itsTasos/RAPS-5/manufacturing/gerbers/drill_report.txt

Drill report for RAPS-5_V1.kicad_pcb
Created on 2026-10-02T12:42:03

Copper Layer Stackup:
    =============================================================
    L1 :  F.Cu                      front
    L2 :  In1.Cu                    in1
    L3 :  In2.Cu                    in2
    L4 :  B.Cu                      back

Drill file 'RAPS-5_V1-PTH.drl' contains
    plated through holes:
    =============================================================
    T1  0.300mm  0.0118"  (161 holes))
    T2  0.400mm  0.0157"  (29 holes))
    T3  0.500mm  0.0197"  (14 holes))
    T4  1.100mm  0.0433"  (6 holes))

    Total plated holes count 210

Drill file 'RAPS-5_V1-NPTH.drl' contains
    unplated through holes:
    =============================================================
    T1  2.200mm  0.0866"  (4 holes))

    Total unplated holes count 4
