itsTasos/RAPS-5/validation/bench_results.csv

Test_ID | Source_mode | VIN_A_set_V | VIN_B_set_V | Load_set_A | Ambient_C | Measured_VIN_A_V | Measured_VIN_B_V | IIN_A_A | IIN_B_A | Local_A_V | Local_B_V | BUS_V | Ripple_pp_mV_20MHz | Hottest_case_C | Hot_component | Duration_min | PG_A | PG_B | PG_BUS | Pass_Fail | Notes
DC01 | A only | 6.7 |  | 0.1
DC02 | A only | 6.7 |  | 1
DC03 | A only | 6.7 |  | 2
DC04 | A only | 6.7 |  | 3
DC05 | A only | 8.4 |  | 0.1
DC06 | A only | 8.4 |  | 1
DC07 | A only | 8.4 |  | 2
DC08 | A only | 8.4 |  | 3
DC09 | A only | 16.8 |  | 0.1
DC10 | A only | 16.8 |  | 1
DC11 | A only | 16.8 |  | 2
DC12 | A only | 16.8 |  | 3
DC13 | A only | 25.2 |  | 0.1
DC14 | A only | 25.2 |  | 1
DC15 | A only | 25.2 |  | 2
DC16 | A only | 25.2 |  | 3
DC17 | B only |  | 6.7 | 0.1
DC18 | B only |  | 6.7 | 1
DC19 | B only |  | 6.7 | 2
DC20 | B only |  | 6.7 | 3
DC21 | B only |  | 8.4 | 0.1
DC22 | B only |  | 8.4 | 1
DC23 | B only |  | 8.4 | 2
DC24 | B only |  | 8.4 | 3
DC25 | B only |  | 16.8 | 0.1
DC26 | B only |  | 16.8 | 1
DC27 | B only |  | 16.8 | 2
DC28 | B only |  | 16.8 | 3
DC29 | B only |  | 25.2 | 0.1
DC30 | B only |  | 25.2 | 1
DC31 | B only |  | 25.2 | 2
DC32 | B only |  | 25.2 | 3
DC33 | Both | 6.7 | 6.7 | 0.1
DC34 | Both | 6.7 | 6.7 | 1
DC35 | Both | 6.7 | 6.7 | 2
DC36 | Both | 6.7 | 6.7 | 3
DC37 | Both | 8.4 | 8.4 | 0.1
DC38 | Both | 8.4 | 8.4 | 1
DC39 | Both | 8.4 | 8.4 | 2
DC40 | Both | 8.4 | 8.4 | 3
DC41 | Both | 16.8 | 16.8 | 0.1
DC42 | Both | 16.8 | 16.8 | 1
DC43 | Both | 16.8 | 16.8 | 2
DC44 | Both | 16.8 | 16.8 | 3
DC45 | Both | 25.2 | 25.2 | 0.1
DC46 | Both | 25.2 | 25.2 | 1
DC47 | Both | 25.2 | 25.2 | 2
DC48 | Both | 25.2 | 25.2 | 3
DC49 | Both | 6.7 | 25.2 | 0.1
DC50 | Both | 6.7 | 25.2 | 1
DC51 | Both | 6.7 | 25.2 | 2
DC52 | Both | 6.7 | 25.2 | 3
DC53 | Both | 25.2 | 6.7 | 0.1
DC54 | Both | 25.2 | 6.7 | 1
DC55 | Both | 25.2 | 6.7 | 2
DC56 | Both | 25.2 | 6.7 | 3
