itsTasos/RAPS-5/docs/drawings/RAPS-5_schematic.pdf

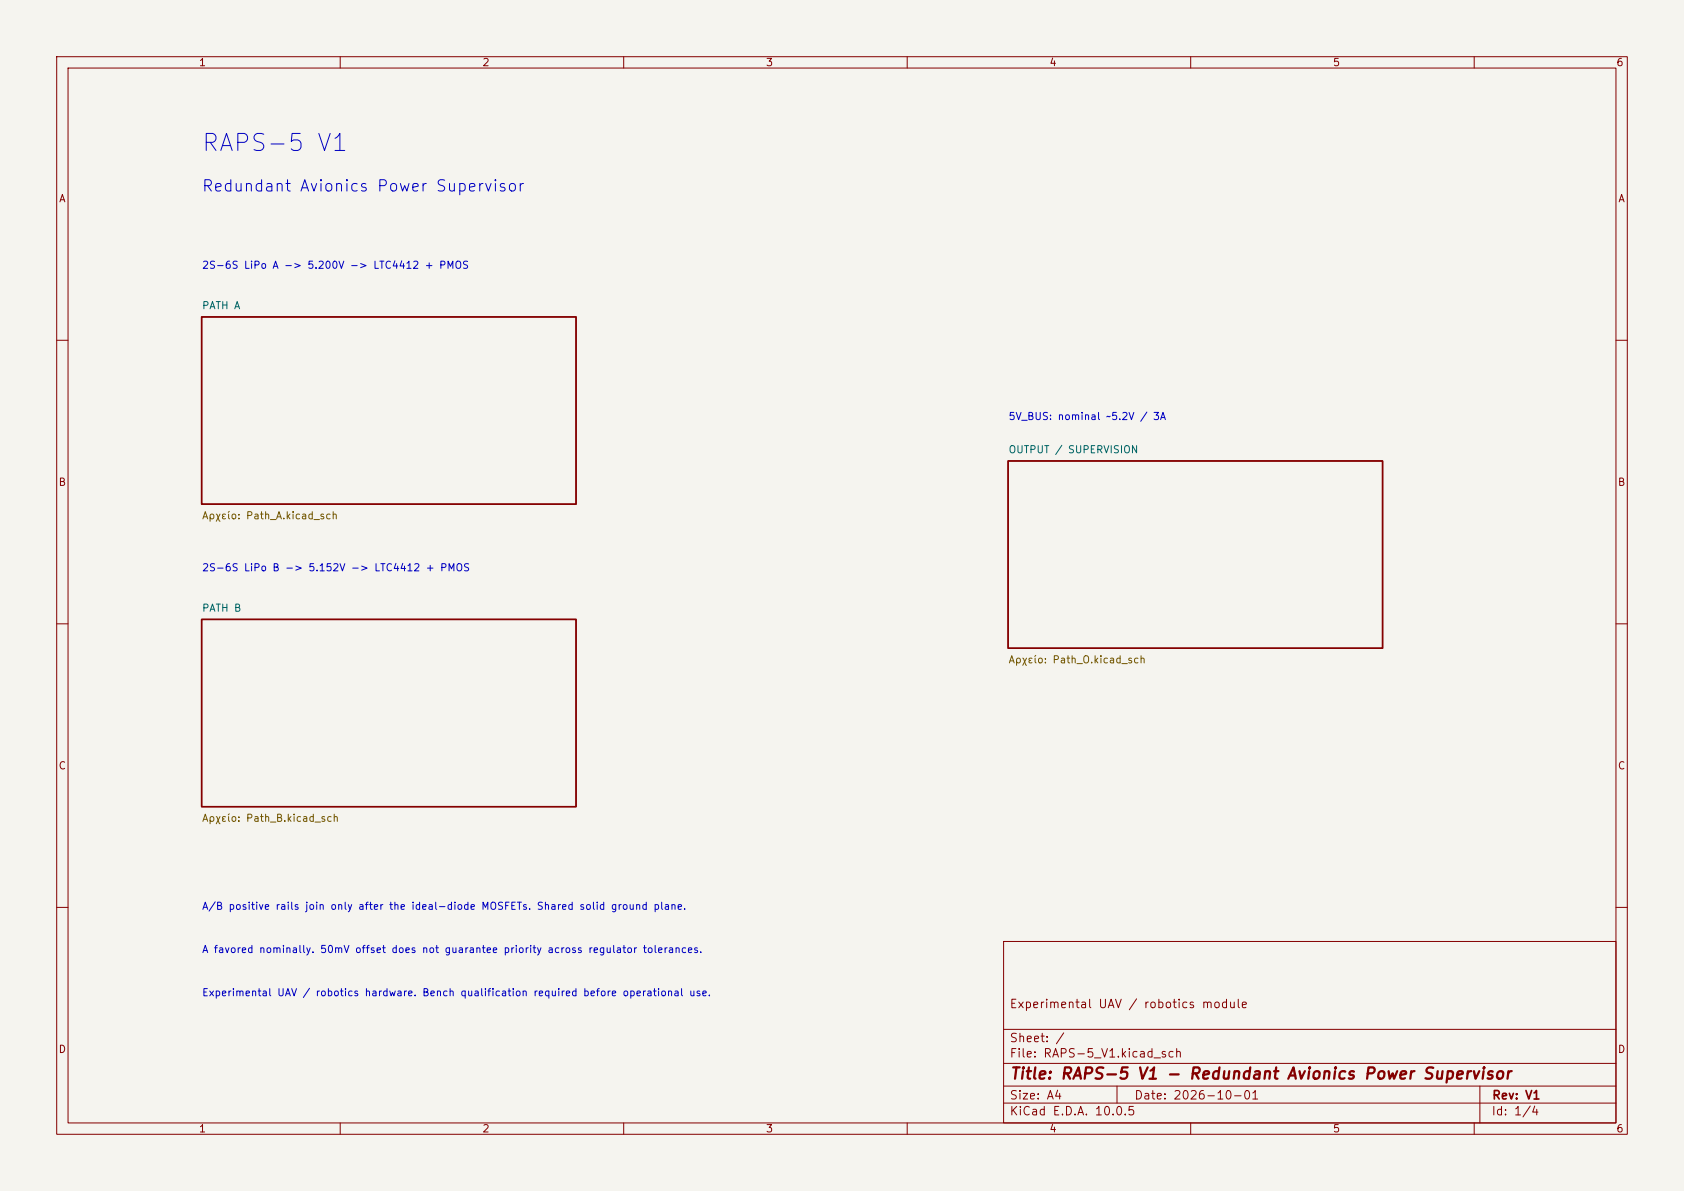
[picture p4: page 1]

A/B positive rails join only after the ideal-diode MOSFETs. Shared solid ground plane. A favored nominally. 50mV offset does not guarantee priority across regulator tolerances. RAPS-5 V1

Redundant Avionics Power Supervisor

Experimental UAV / robotics hardware. Bench qualification required before operational use. 2S-6S LiPo B -> 5.152V -> LTC4412 + PMOS

Experimental UAV / robotics module

Sheet: /
File: RAPS-5_V1.kicad_sch
Title: RAPS-5 V1 - Redundant Avionics Power Supervisor

Size: A4 | Rev: V1
KiCad E.D.A. 10.0.5 | Id: 1/4

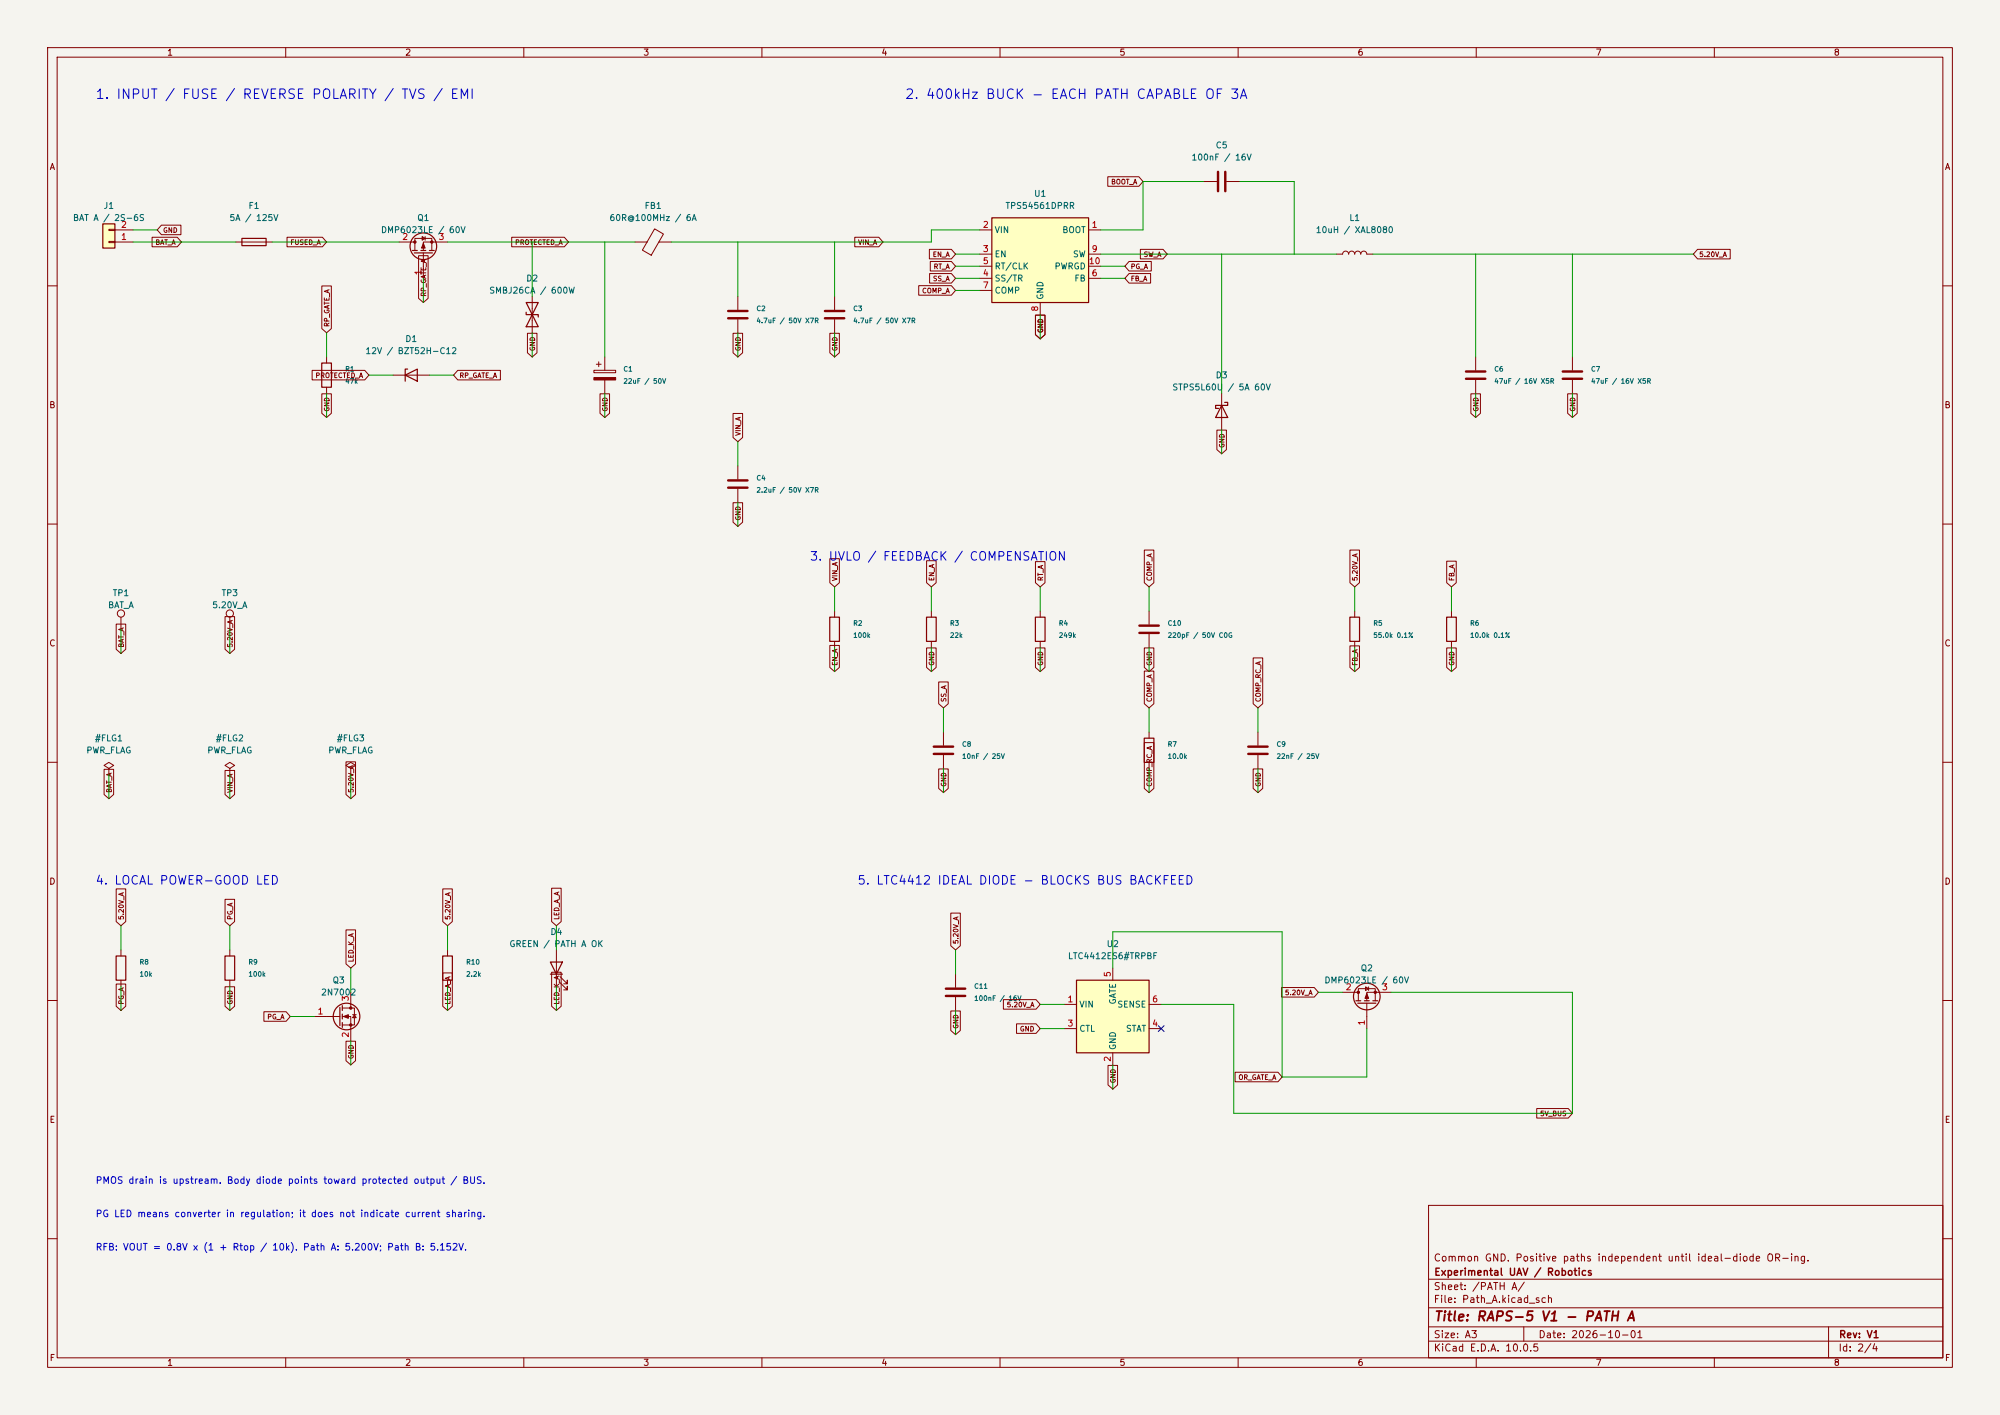
[picture p5: page 2]

1. INPUT / FUSE / REVERSE POLARITY / TVS / EMI

2. 400kHz BUCK - EACH PATH CAPABLE OF 3A

5. LTC4412 IDEAL DIODE - BLOCKS BUS BACKFEED

PMOS drain is upstream. Body diode points toward protected output / BUS.

PG LED means converter in regulation; it does not indicate current sharing.

RFB: VOUT = 0.8V x (1 + Rtop / 10k). Path A: 5.200V; Path B: 5.152V.

Common GND. Positive paths independent until ideal-diode OR-ing.
Experimental UAV / Robotics
Sheet: /PATH A/
File: Path_A.kicad_sch
Title: RAPS-5 V1 - PATH A

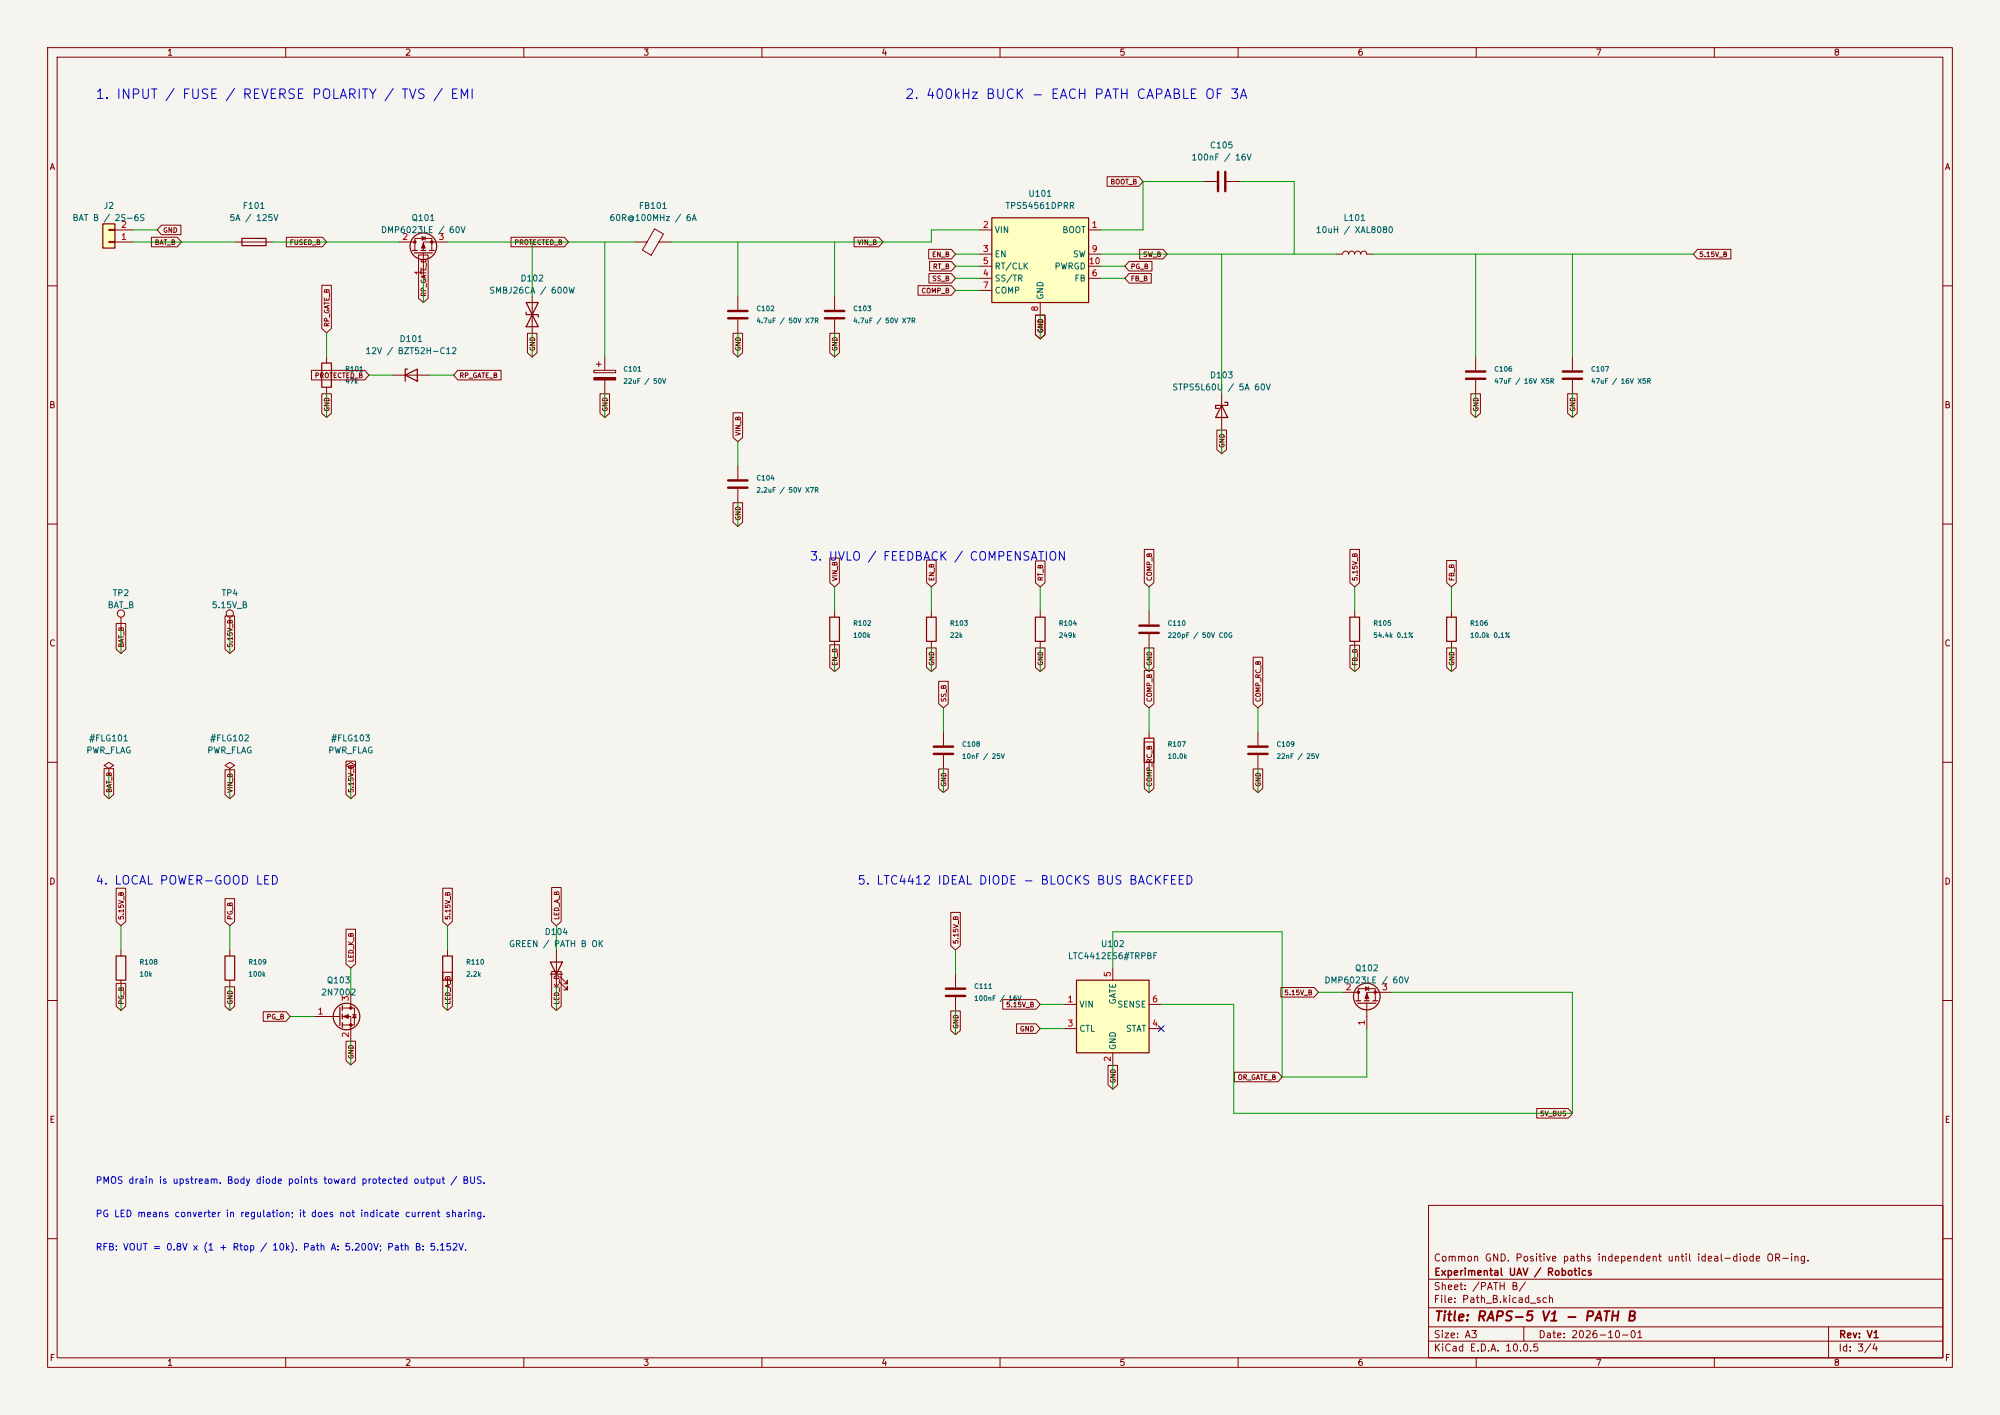
[picture p6: page 3]

1. INPUT / FUSE / REVERSE POLARITY / TVS / EMI

2. 400kHz BUCK - EACH PATH CAPABLE OF 3A

4. LOCAL POWER-GOOD LED

PMOS drain is upstream. Body diode points toward protected output / BUS.

PG LED means converter in regulation; it does not indicate current sharing.

Common GND. Positive paths independent until ideal-diode OR-ing.
Experimental UAV / Robotics
Sheet: /PATH B/
File: Path_B.kicad_sch
Title: RAPS-5 V1 - PATH B

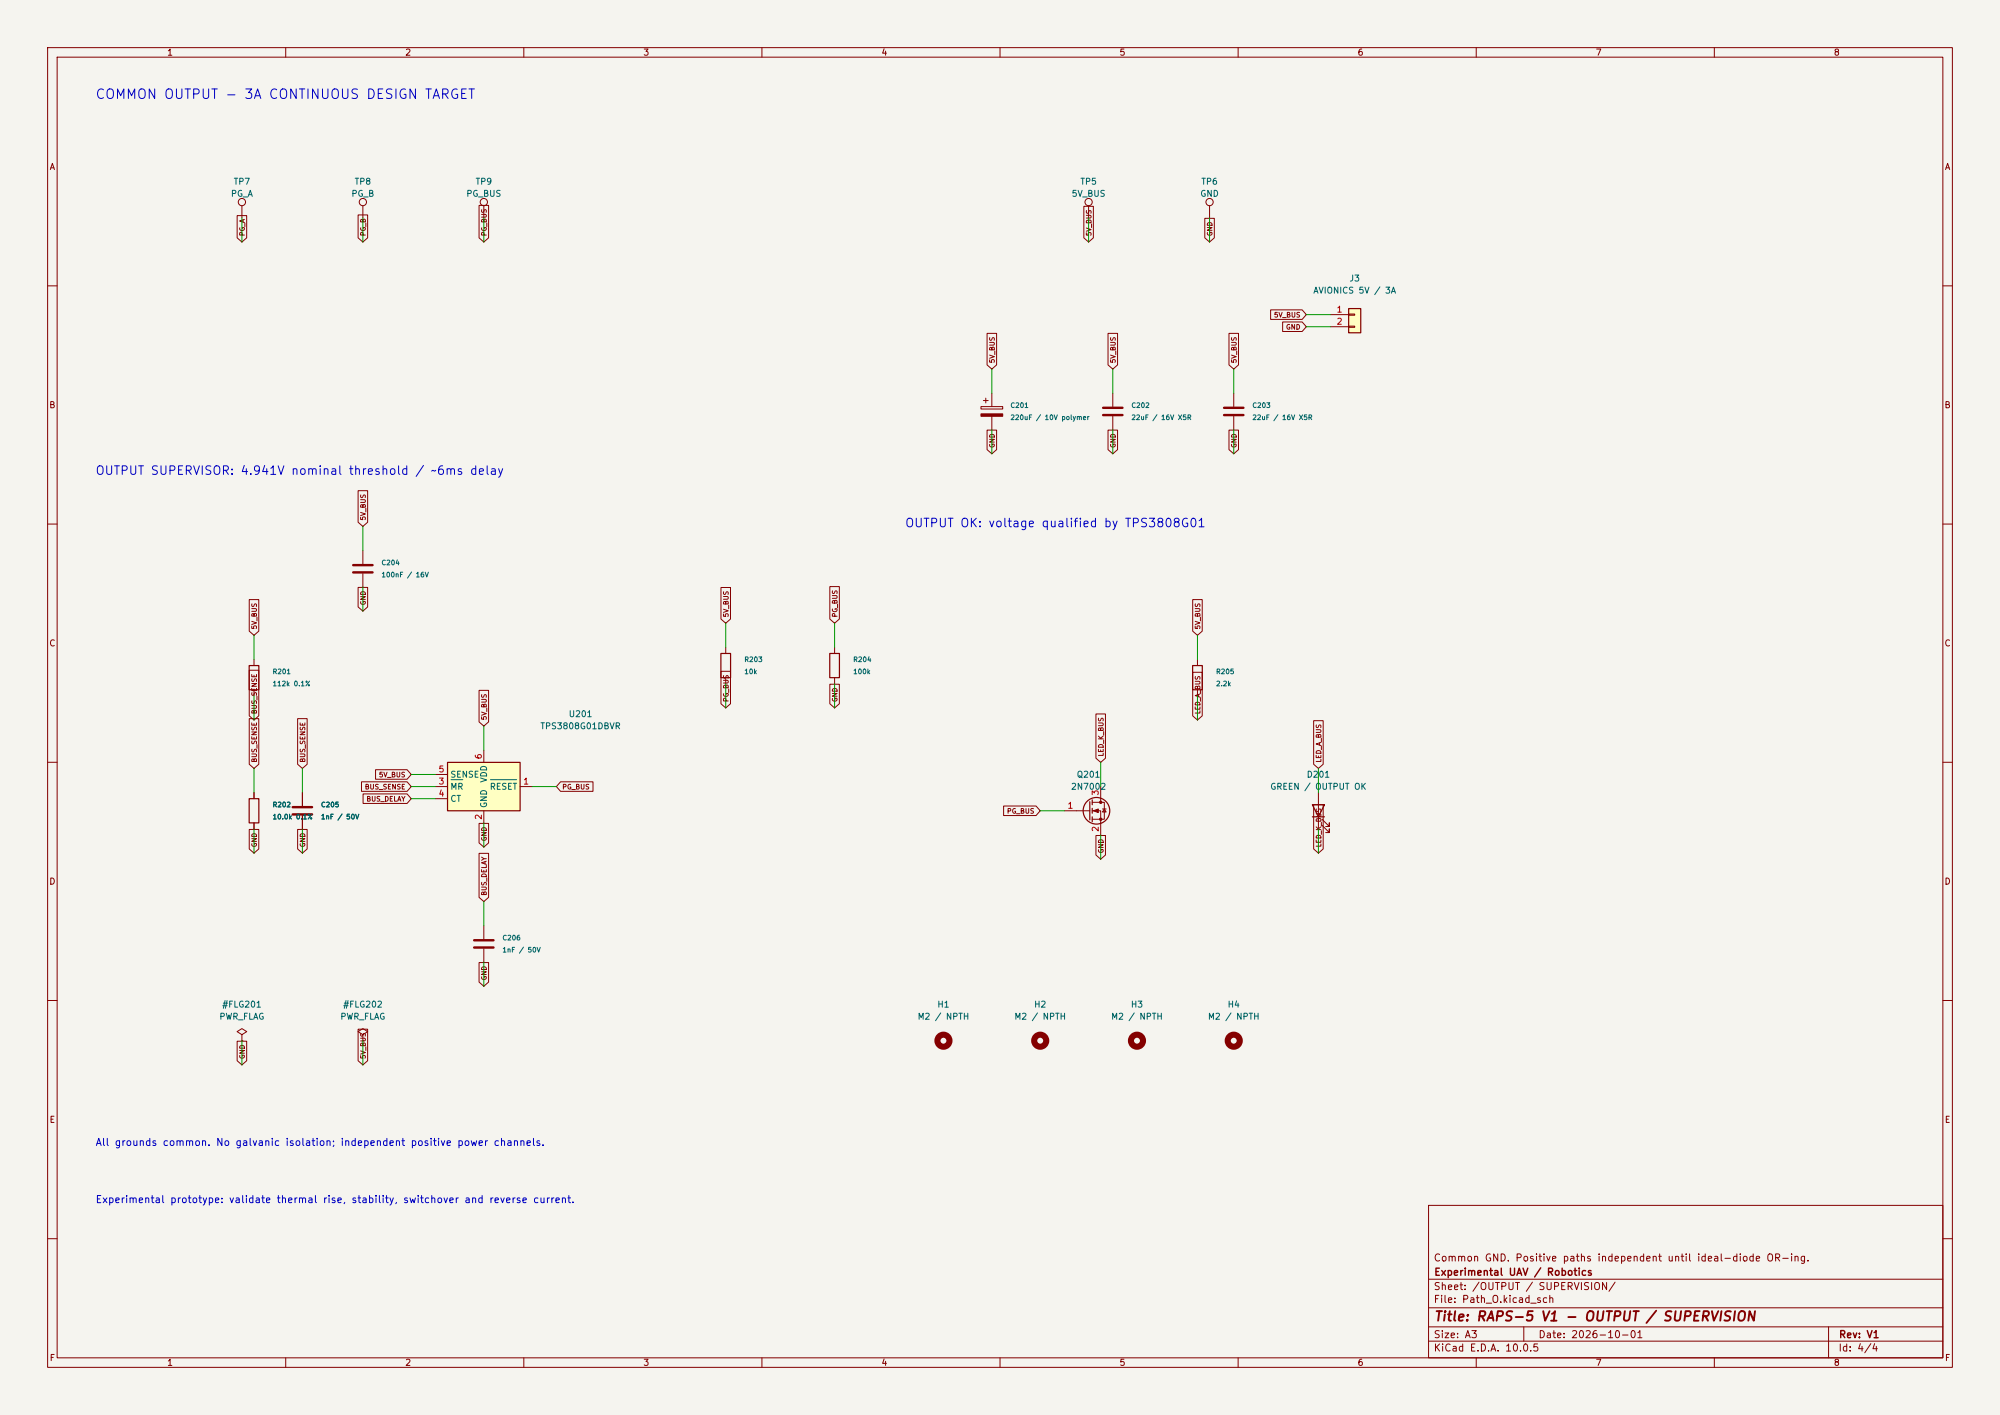
[picture p7: page 4]

COMMON OUTPUT - 3A CONTINUOUS DESIGN TARGET
BUS_SENSE 5V_BUS PG_B

OUTPUT SUPERVISOR: 4.941V nominal threshold / ~6ms delay

OUTPUT OK: voltage qualified by TPS3808G01

All grounds common. No galvanic isolation; independent positive power channels.

Experimental prototype: validate thermal rise, stability, switchover and reverse current.

Common GND. Positive paths independent until ideal-diode OR-ing.
Experimental UAV / Robotics
Sheet: /OUTPUT / SUPERVISION/
File: Path_O.kicad_sch
Title: RAPS-5 V1 - OUTPUT / SUPERVISION
