itsTasos/RAPS-5/docs/drawings/RAPS-5_assembly.pdf

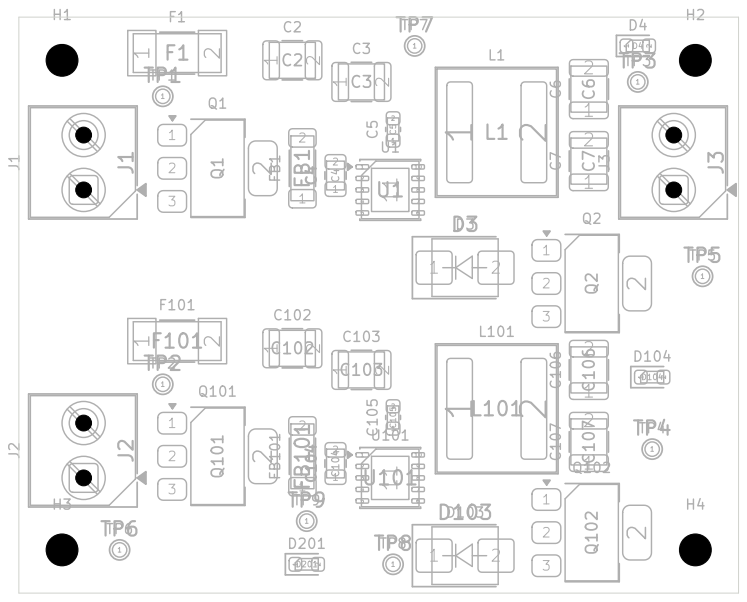
[picture p8: page 1]

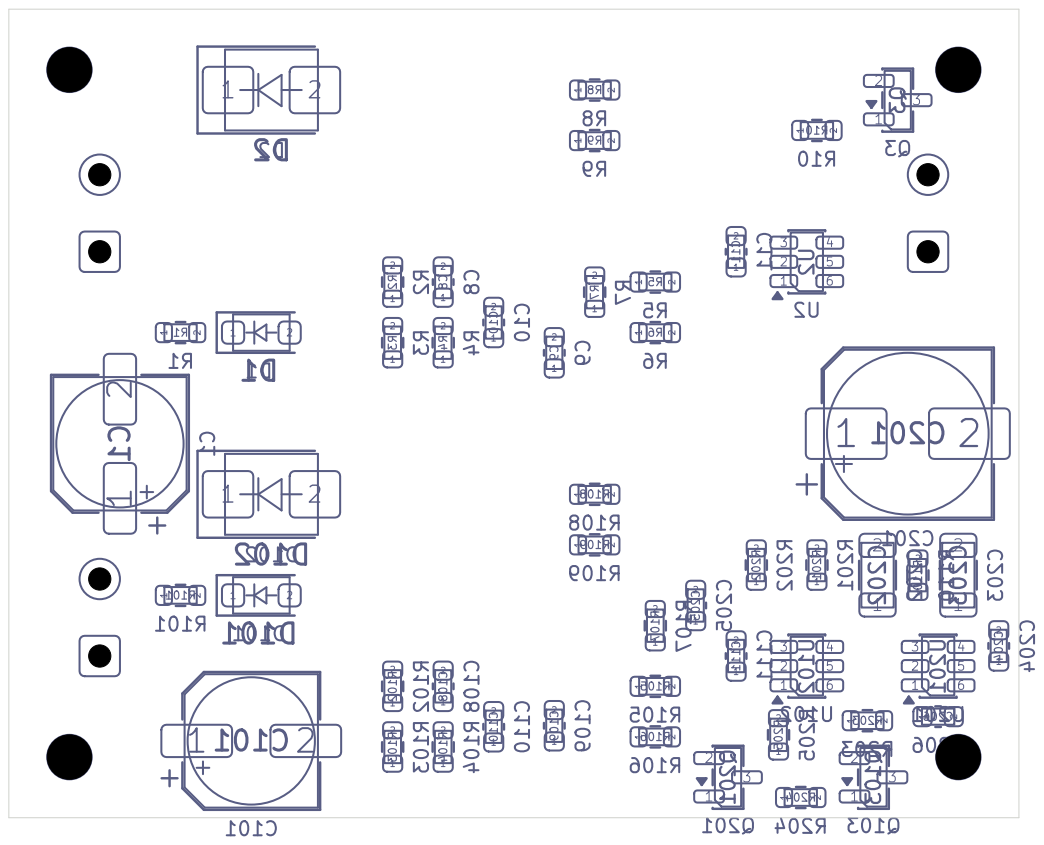
[picture p9: page 2]
