itsTasos/RAPS-5/docs/drawings/RAPS-5_copper.pdf

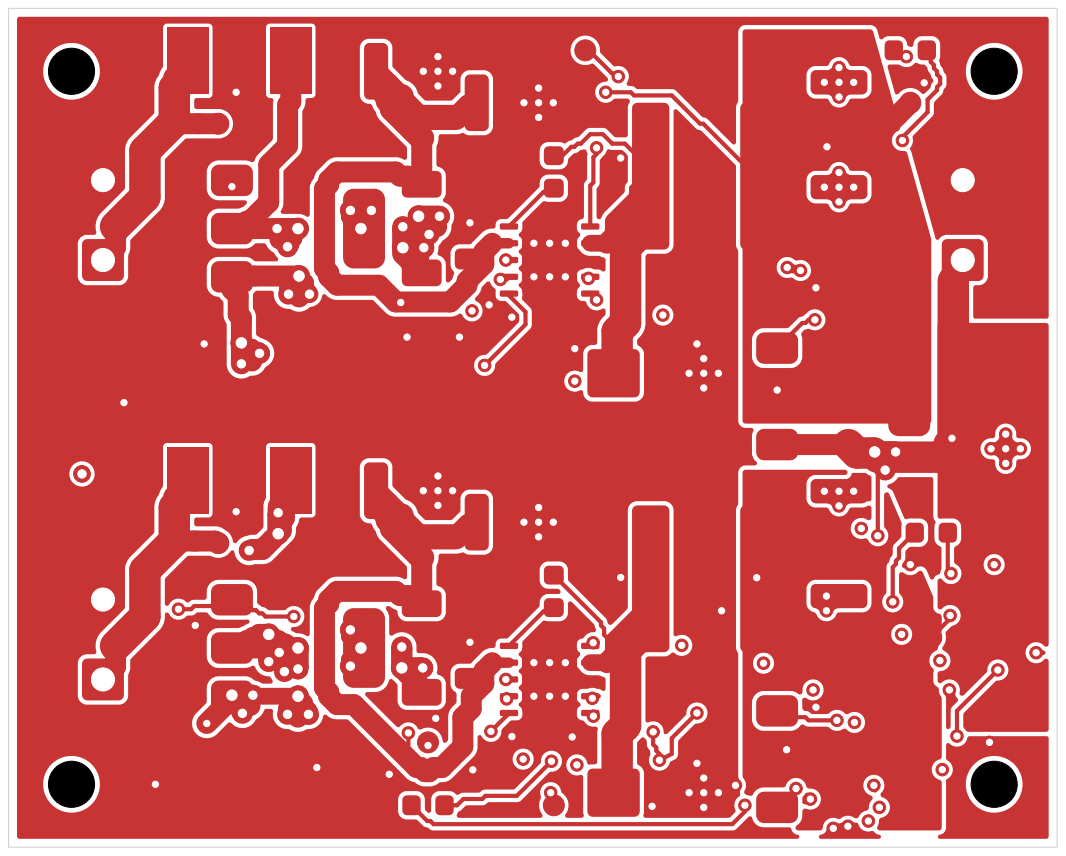
[picture p10: page 1]

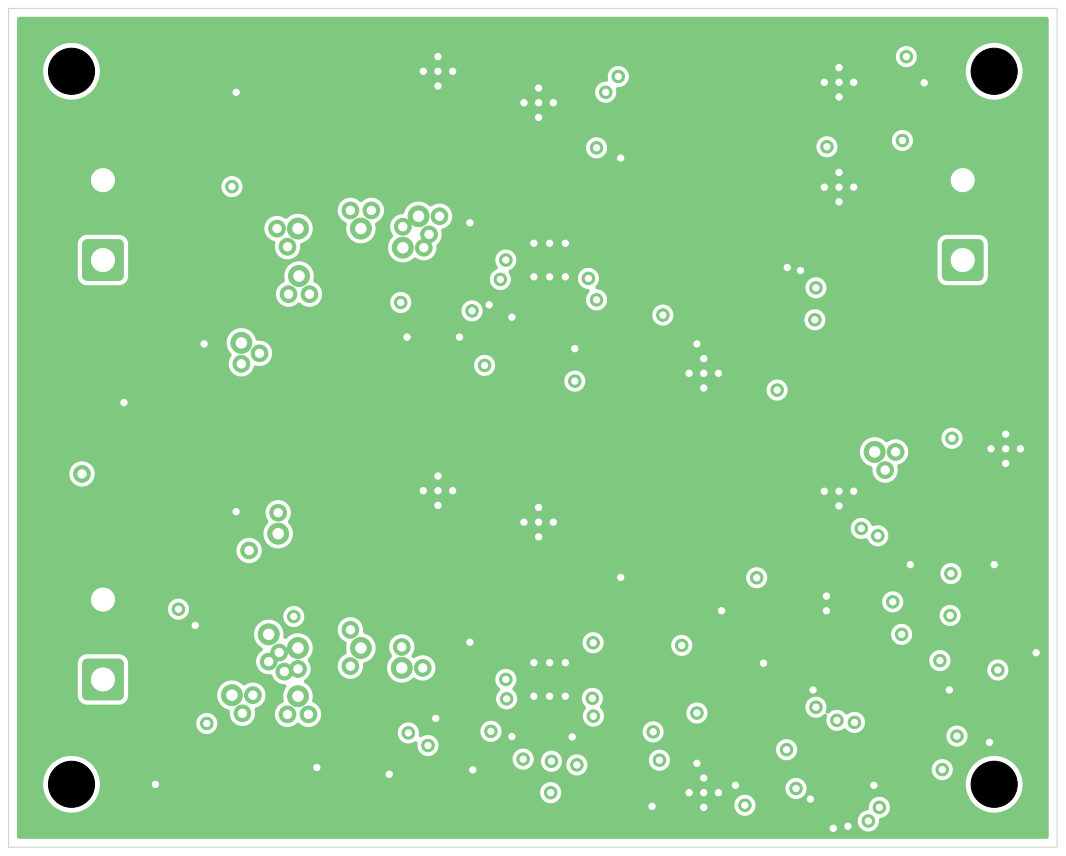
[picture p11: page 2]

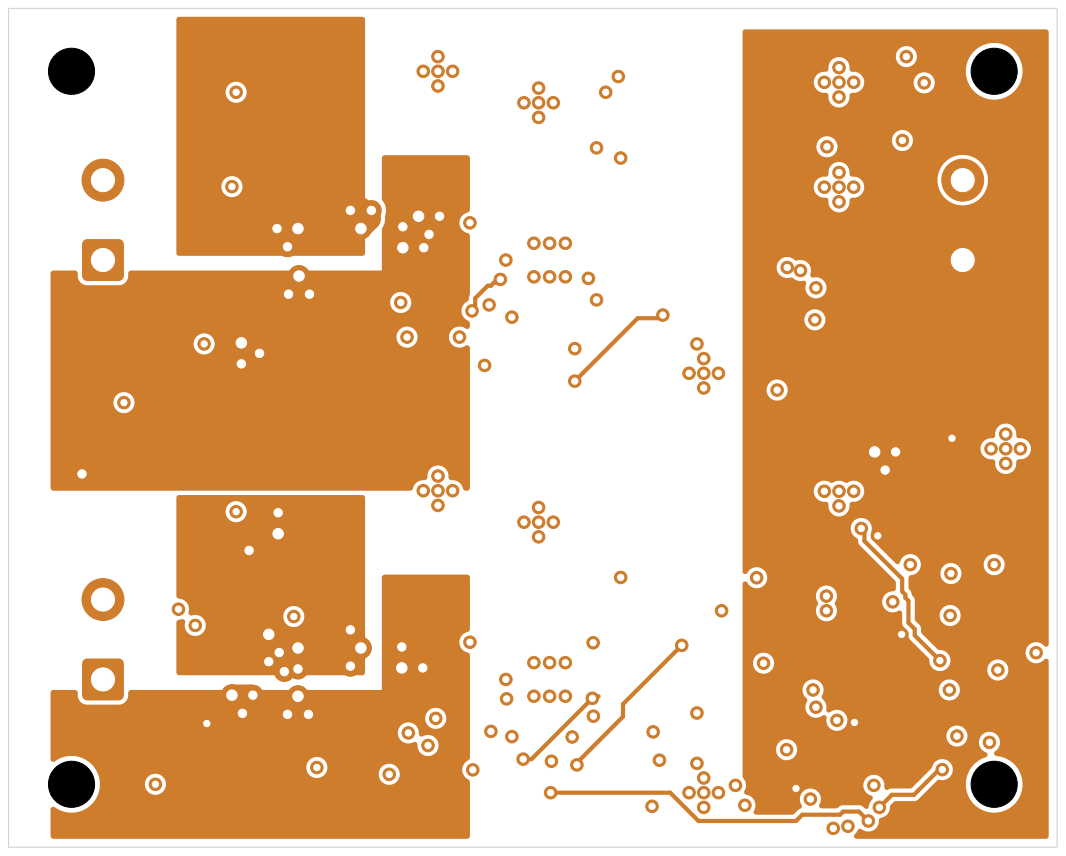
[picture p12: page 3]

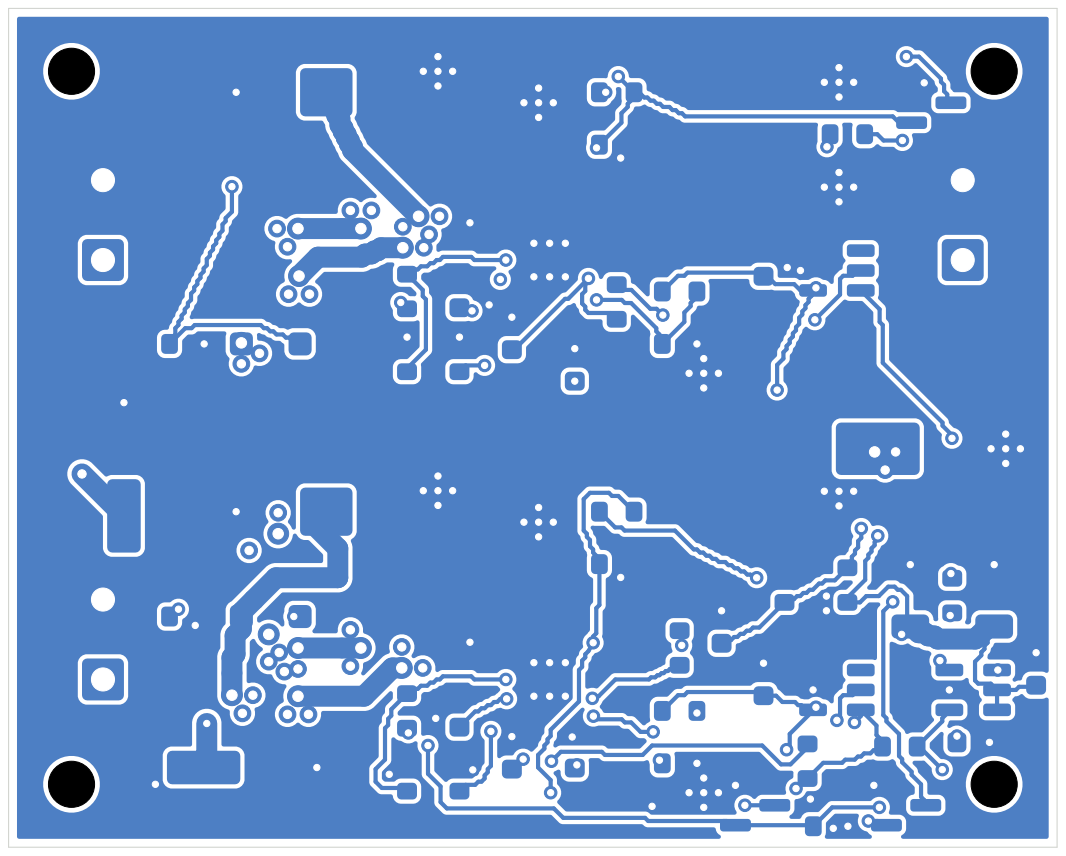
[picture p13: page 4]
