itsTasos/RAPS-5/hardware/RAPS-5_V1.kicad_pcb

## KiCad design hardware/RAPS-5_V1.kicad_pcb (2026-10-14)

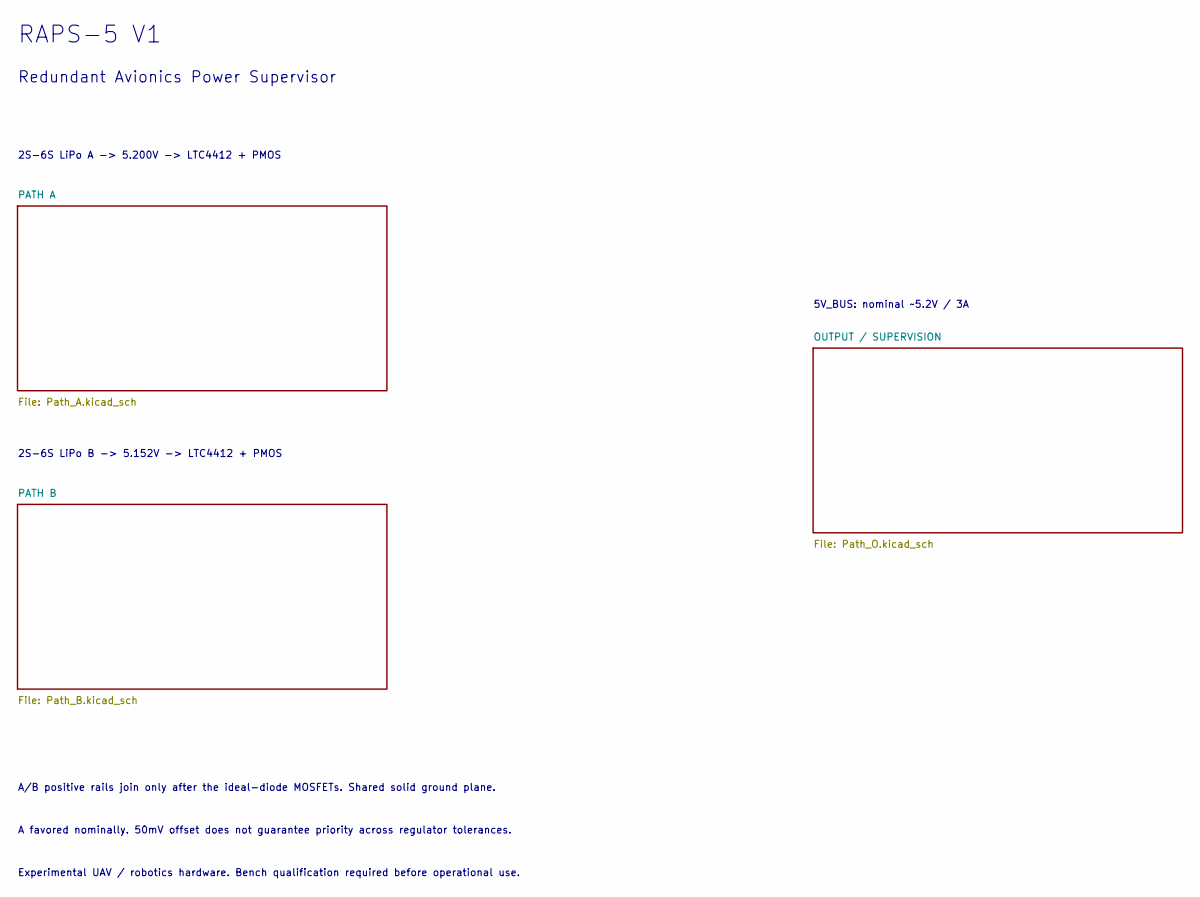
[picture p14: schematic RAPS-5_V1.kicad_sch, RAPS-5 V1 - Redundant Avionics Power Supervisor]

Notes on the sheet:
Experimental UAV / robotics hardware. Bench qualification required before operational use.
RAPS-5 V1
2S-6S LiPo B -> 5.152V -> LTC4412 + PMOS
Redundant Avionics Power Supervisor
5V_BUS: nominal ~5.2V / 3A
A/B positive rails join only after the ideal-diode MOSFETs. Shared solid ground plane.
A favored nominally. 50mV offset does not guarantee priority across regulator tolerances.
2S-6S LiPo A -> 5.200V -> LTC4412 + PMOS

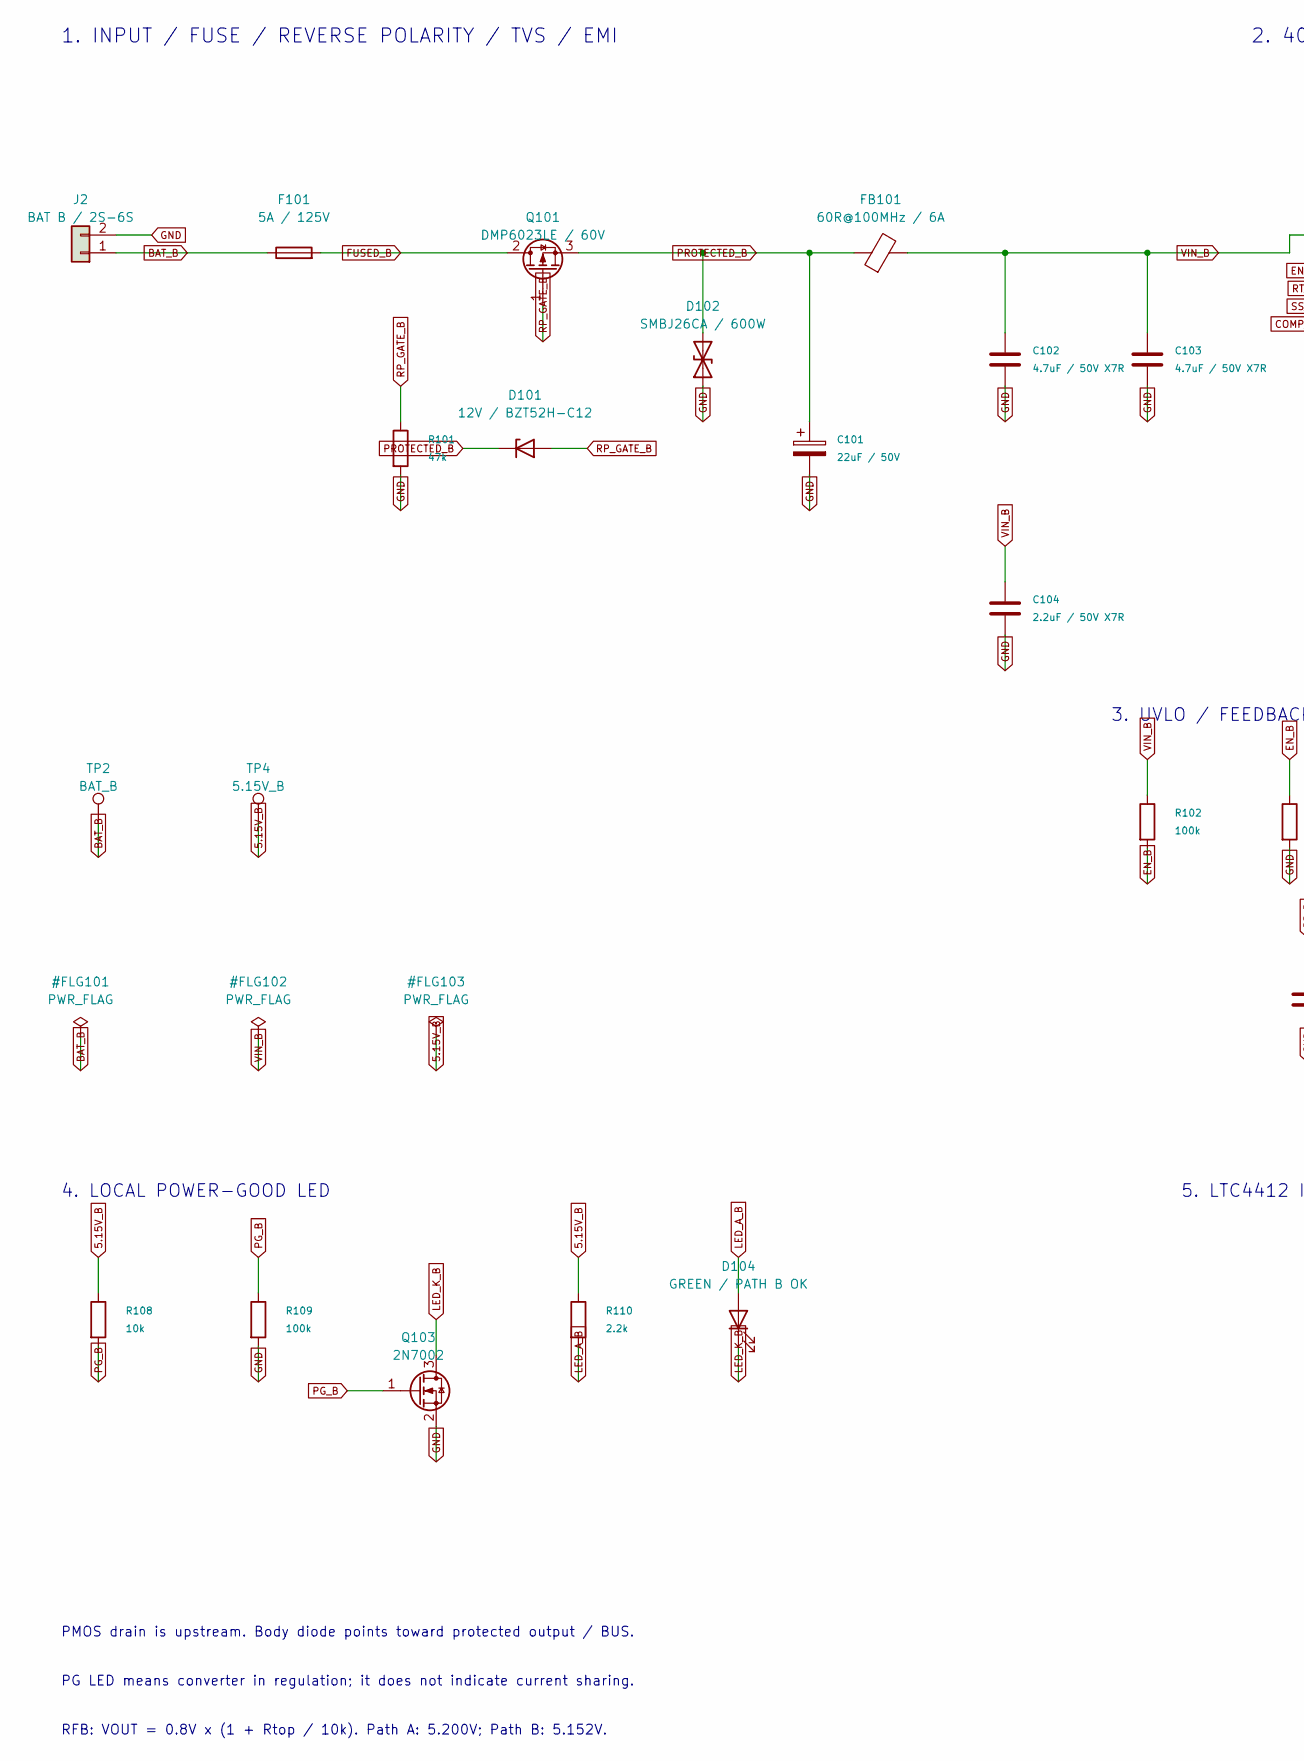
[picture p15: schematic Path_B.kicad_sch, RAPS-5 V1 - PATH B, part in row 1, column 1]

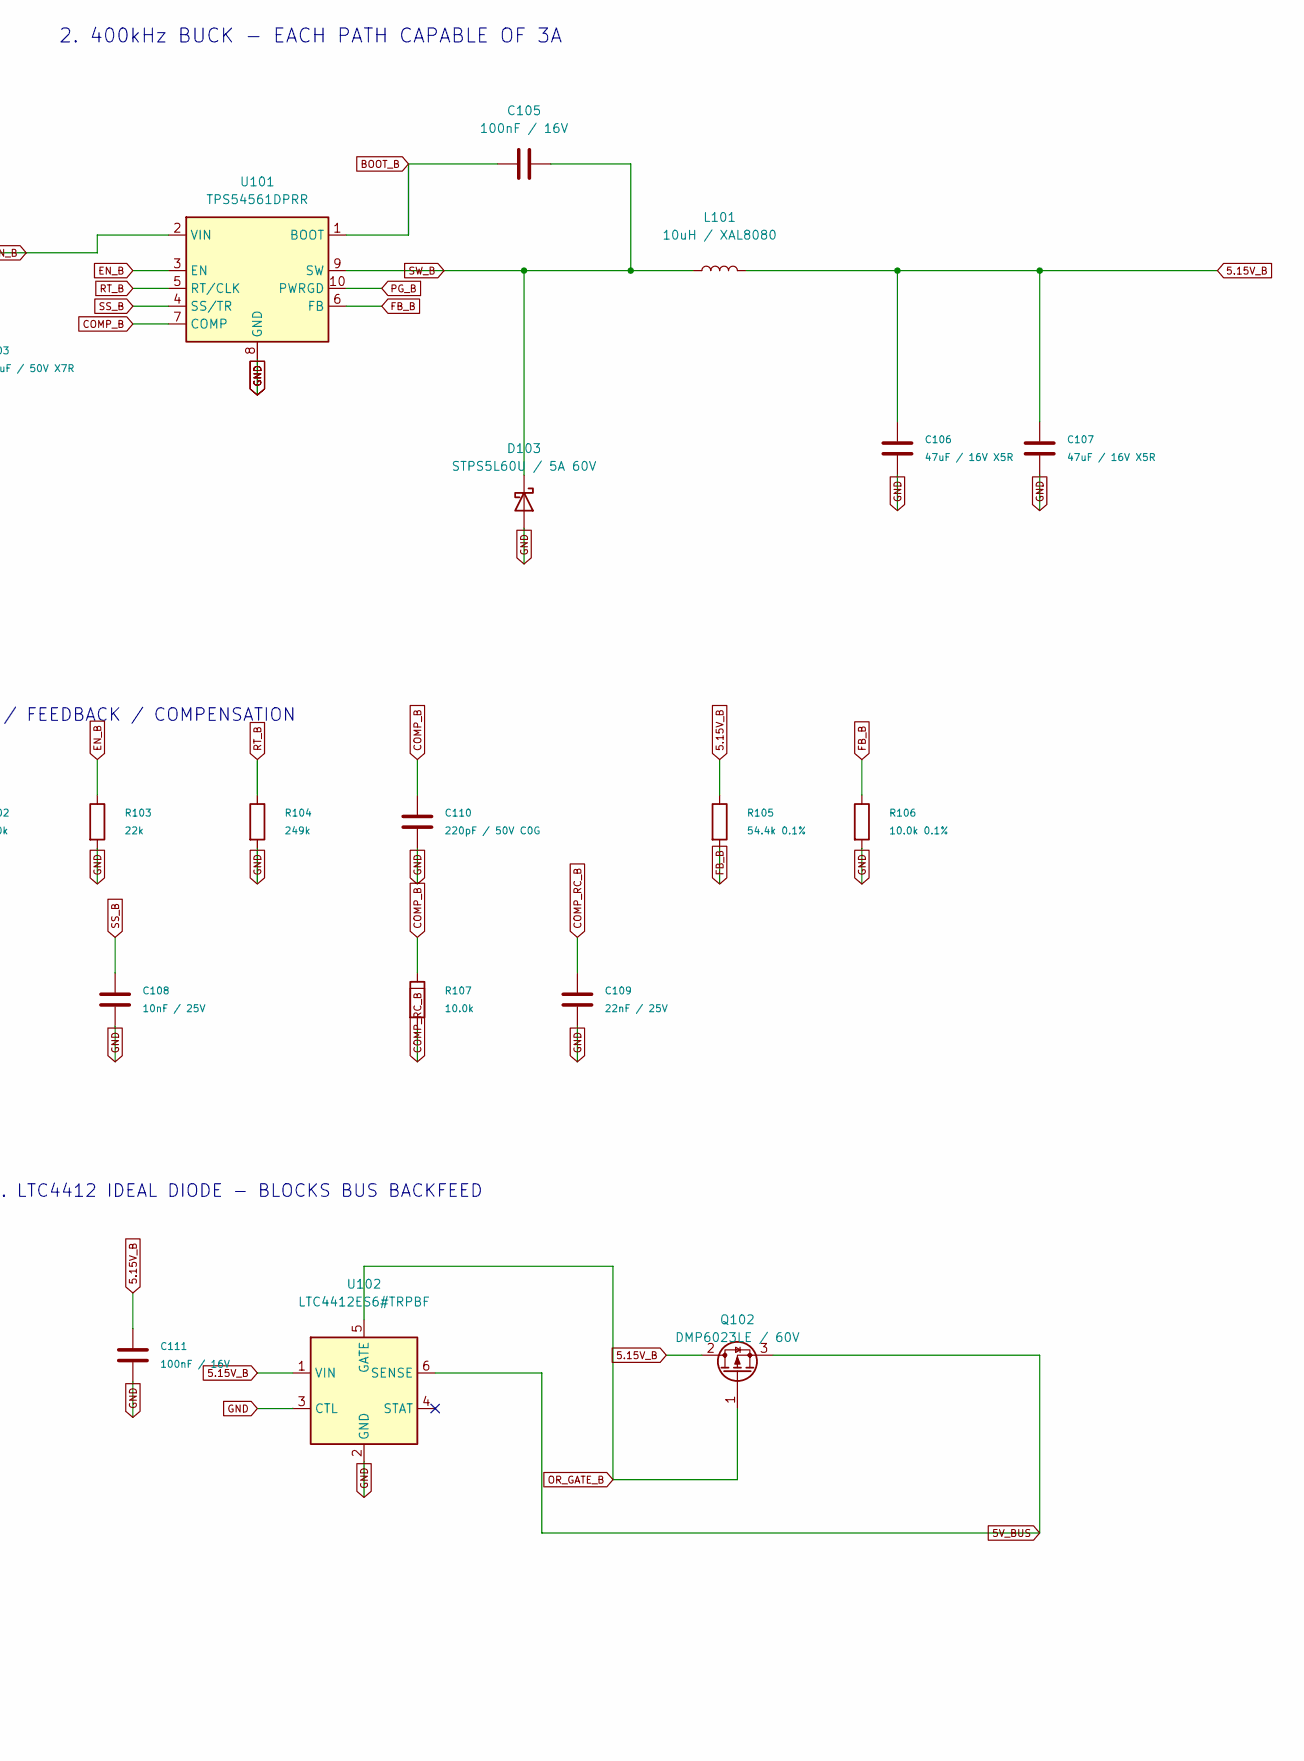
[picture p16: schematic Path_B.kicad_sch, RAPS-5 V1 - PATH B, part in row 1, column 2]

Parts:
C101: 22uF / 50V; CP_Elec_6.3x7.7; MPN EEE-FK1H220P
C102, C103: 4.7uF / 50V X7R; C_1210_3225Metric; MPN GRM32ER71H475KA88L
C104: 2.2uF / 50V X7R; C_0805_2012Metric; MPN GRM21BR71H225KA12L
C105, C111: 100nF / 16V; C_0603_1608Metric; MPN GRM188R71C104KA01D
C106, C107: 47uF / 16V X5R; C_1210_3225Metric; MPN GRM32ER61C476KE15L
C108: 10nF / 25V; C_0603_1608Metric; MPN GRM188R71E103KA01D
C109: 22nF / 25V; C_0603_1608Metric; MPN GRM188R71E223KA01D
C110: 220pF / 50V C0G; C_0603_1608Metric; MPN GRM1885C1H221JA01D
D101: 12V / BZT52H-C12; D_SOD-123F; MPN BZT52H-C12
D102: SMBJ26CA / 600W; D_SMB; MPN SMBJ26CA
D103: STPS5L60U / 5A 60V; D_SMB; MPN STPS5L60U
D104: GREEN / PATH B OK; LED_0603_1608Metric; MPN LTST-C190KGKT
F101: 5A / 125V; Fuse_Littelfuse-NANO2-451_453; MPN 0451005.MRL
FB101: 60R@100MHz / 6A; L_1806_4516Metric; MPN 742792410
J2: BAT B / 2S-6S; TerminalBlock_Phoenix_MKDS-1-2-3.81_1x02_P3.81mm_Horizontal; MPN 1727010
L101: 10uH / XAL8080; L_Coilcraft_XAL8080-XXX; MPN XAL8080-103MED
Q101, Q102: DMP6023LE / 60V; SOT-223-3_TabPin2; MPN DMP6023LE-13
Q103: 2N7002; SOT-23; MPN 2N7002-7-F
R101: 47k; R_0603_1608Metric; MPN RC0603FR-0747KL
R102, R109: 100k; R_0603_1608Metric
R103: 22k; R_0603_1608Metric
R104: 249k; R_0603_1608Metric
R105: 54.4k 0.1%; R_0603_1608Metric
R106: 10.0k 0.1%; R_0603_1608Metric
R107: 10.0k; R_0603_1608Metric
R108: 10k; R_0603_1608Metric
R110: 2.2k; R_0603_1608Metric
TP2: BAT_B; TestPoint_Pad_D1.0mm
TP4: 5.15V_B; TestPoint_Pad_D1.0mm
U101: TPS54561DPRR; WSON-10-1EP_4x4mm_P0.8mm_EP2.6x3mm; MPN TPS54561DPRR
U102: LTC4412ES6#TRPBF; TSOT-23-6; MPN LTC4412ES6#TRPBF

Connections:
5.15V_B: C106.1, C107.1, C111.1, L101.2, Q102.2 (D), R105.1, R108.1, R110.1, TP4.1, U102.1 (VIN)
5V_BUS: Q102.3 (S), U102.6 (SENSE); also elsewhere on the board
BAT_B: F101.1, J2.1, TP2.1
BOOT_B: C105.1, U101.1 (BOOT)
COMP_B: C110.1, R107.1, U101.7 (COMP)
COMP_RC_B: C109.1, R107.2
EN_B: R102.2, R103.1, U101.3 (EN)
FB_B: R105.2, R106.1, U101.6 (FB)
FUSED_B: F101.2, Q101.2 (D)
GND: C101.2, C102.2, C103.2, C104.2, C106.2, C107.2, C108.2, C109.2, C110.2, C111.2, D102.1 (A1), D103.2 (A), J2.2, Q103.2 (S), R101.2, R103.2, R104.2, R106.2, R109.2, U101.8 (GND), U101.11 (GND), U102.2 (GND), U102.3 (CTL); also elsewhere on the board
LED_A_B: D104.2 (A), R110.2
LED_K_B: D104.1 (K), Q103.3 (D)
OR_GATE_B: Q102.1 (G), U102.5 (GATE)
PG_B: Q103.1 (G), R108.2, R109.1, U101.10 (PWRGD); also elsewhere on the board
PROTECTED_B: C101.1, D101.1 (K), D102.2 (A2), FB101.1, Q101.3 (S)
RP_GATE_B: D101.2 (A), Q101.1 (G), R101.1
RT_B: R104.1, U101.5 (RT/CLK)
SS_B: C108.1, U101.4 (SS/TR)
SW_B: C105.2, D103.1 (K), L101.1, U101.9 (SW)
VIN_B: C102.1, C103.1, C104.1, FB101.2, R102.1, U101.2 (VIN)

Notes on the sheet:
1. INPUT / FUSE / REVERSE POLARITY / TVS / EMI
4. LOCAL POWER-GOOD LED
5. LTC4412 IDEAL DIODE - BLOCKS BUS BACKFEED
2. 400kHz BUCK - EACH PATH CAPABLE OF 3A
PG LED means converter in regulation; it does not indicate current sharing.
RFB: VOUT = 0.8V x (1 + Rtop / 10k). Path A: 5.200V; Path B: 5.152V.
PMOS drain is upstream. Body diode points toward protected output / BUS.
3. UVLO / FEEDBACK / COMPENSATION

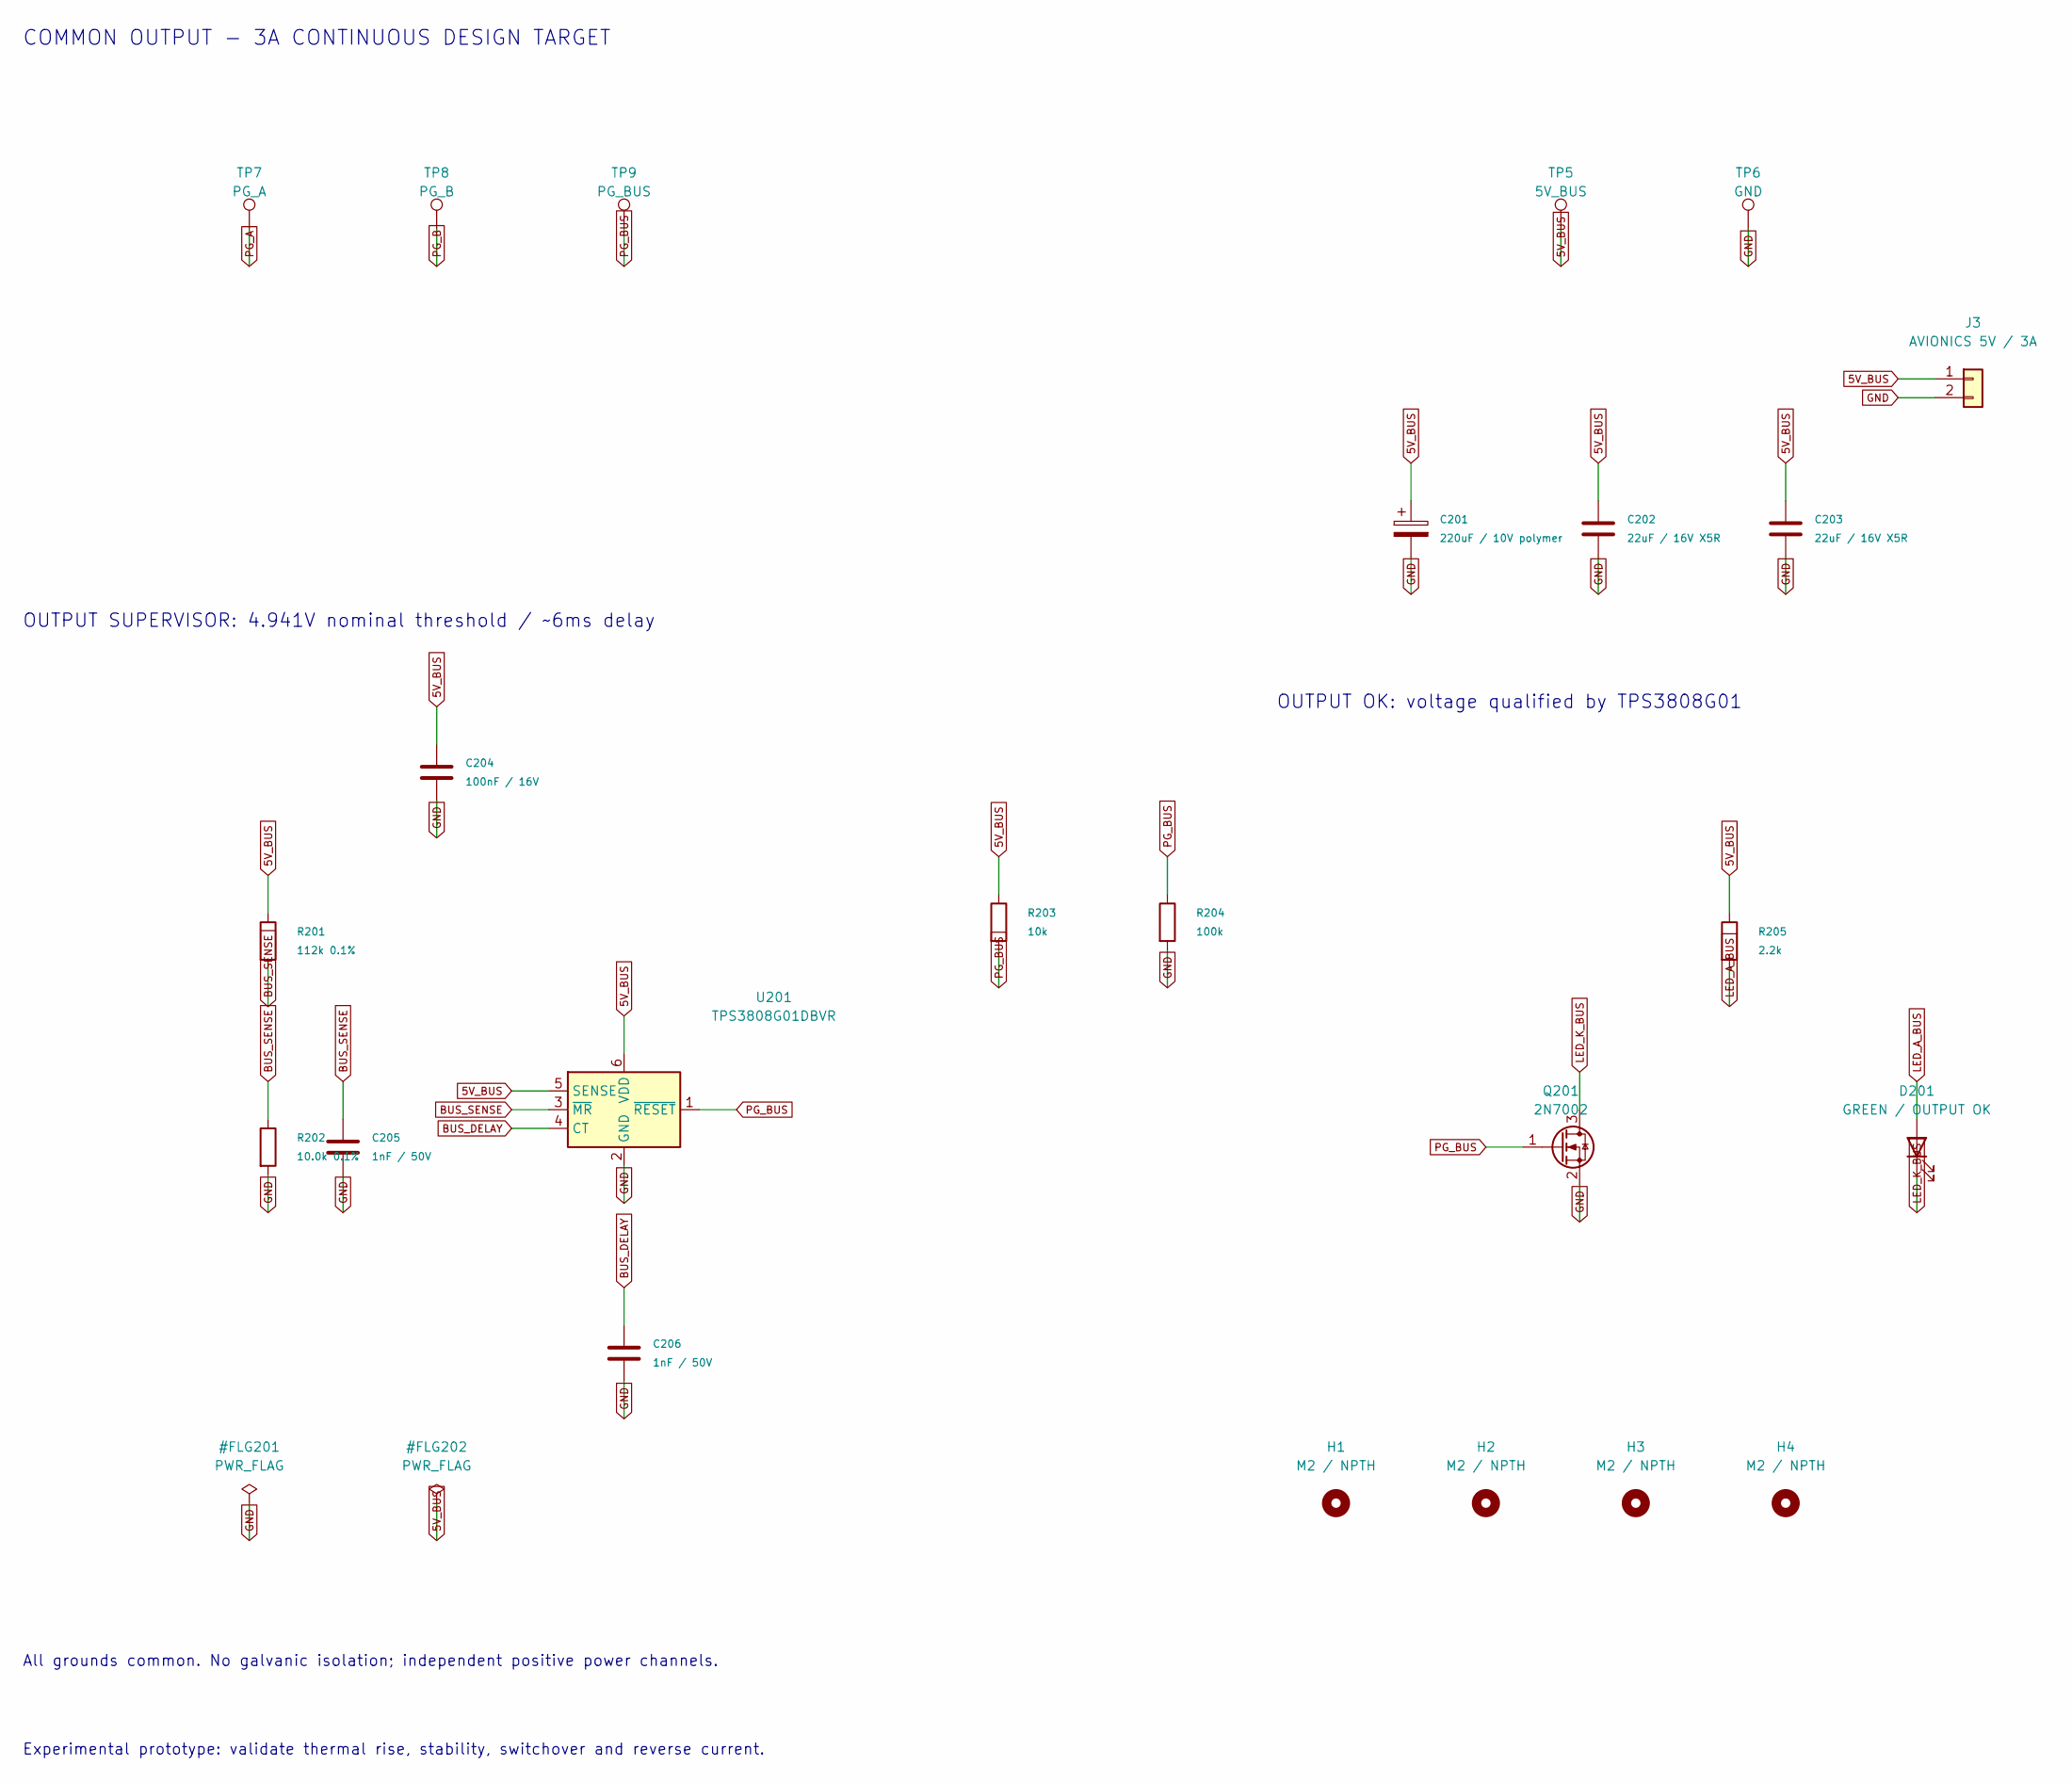
[picture p17: schematic Path_O.kicad_sch, RAPS-5 V1 - OUTPUT / SUPERVISION]

Parts:
C201: 220uF / 10V polymer; CP_Elec_8x6.7; MPN 10SVPF220M
C202, C203: 22uF / 16V X5R; C_1206_3216Metric; MPN GRM31CR61C226KE15L
C204: 100nF / 16V; C_0603_1608Metric
C205, C206: 1nF / 50V; C_0603_1608Metric
D201: GREEN / OUTPUT OK; LED_0603_1608Metric; MPN LTST-C190KGKT
H1, H2, H3, H4: M2 / NPTH; MountingHole_2.2mm_M2
J3: AVIONICS 5V / 3A; TerminalBlock_Phoenix_MKDS-1-2-3.81_1x02_P3.81mm_Horizontal; MPN 1727010
Q201: 2N7002; SOT-23; MPN 2N7002-7-F
R201: 112k 0.1%; R_0603_1608Metric
R202: 10.0k 0.1%; R_0603_1608Metric
R203: 10k; R_0603_1608Metric
R204: 100k; R_0603_1608Metric
R205: 2.2k; R_0603_1608Metric
TP5: 5V_BUS; TestPoint_Pad_D1.0mm
TP6: GND; TestPoint_Pad_D1.0mm
TP7: PG_A; TestPoint_Pad_D1.0mm
TP8: PG_B; TestPoint_Pad_D1.0mm
TP9: PG_BUS; TestPoint_Pad_D1.0mm
U201: TPS3808G01DBVR; SOT-23-6; MPN TPS3808G01DBVR

Connections:
5V_BUS: C201.1, C202.1, C203.1, C204.1, J3.1, R201.1, R203.1, R205.1, TP5.1, U201.5 (SENSE), U201.6 (VDD); also elsewhere on the board
BUS_DELAY: C206.1, U201.4 (CT)
BUS_SENSE: C205.1, R201.2, R202.1, U201.3 (~MR)
GND: C201.2, C202.2, C203.2, C204.2, C205.2, C206.2, J3.2, Q201.2 (S), R202.2, R204.2, TP6.1, U201.2 (GND); also elsewhere on the board
LED_A_BUS: D201.2 (A), R205.2
LED_K_BUS: D201.1 (K), Q201.3 (D)
PG_A: TP7.1; also elsewhere on the board
PG_B: TP8.1; also elsewhere on the board
PG_BUS: Q201.1 (G), R203.2, R204.1, TP9.1, U201.1 (~RESET)

Notes on the sheet:
Experimental prototype: validate thermal rise, stability, switchover and reverse current.
All grounds common. No galvanic isolation; independent positive power channels.
COMMON OUTPUT - 3A CONTINUOUS DESIGN TARGET
OUTPUT OK: voltage qualified by TPS3808G01
OUTPUT SUPERVISOR: 4.941V nominal threshold / ~6ms delay

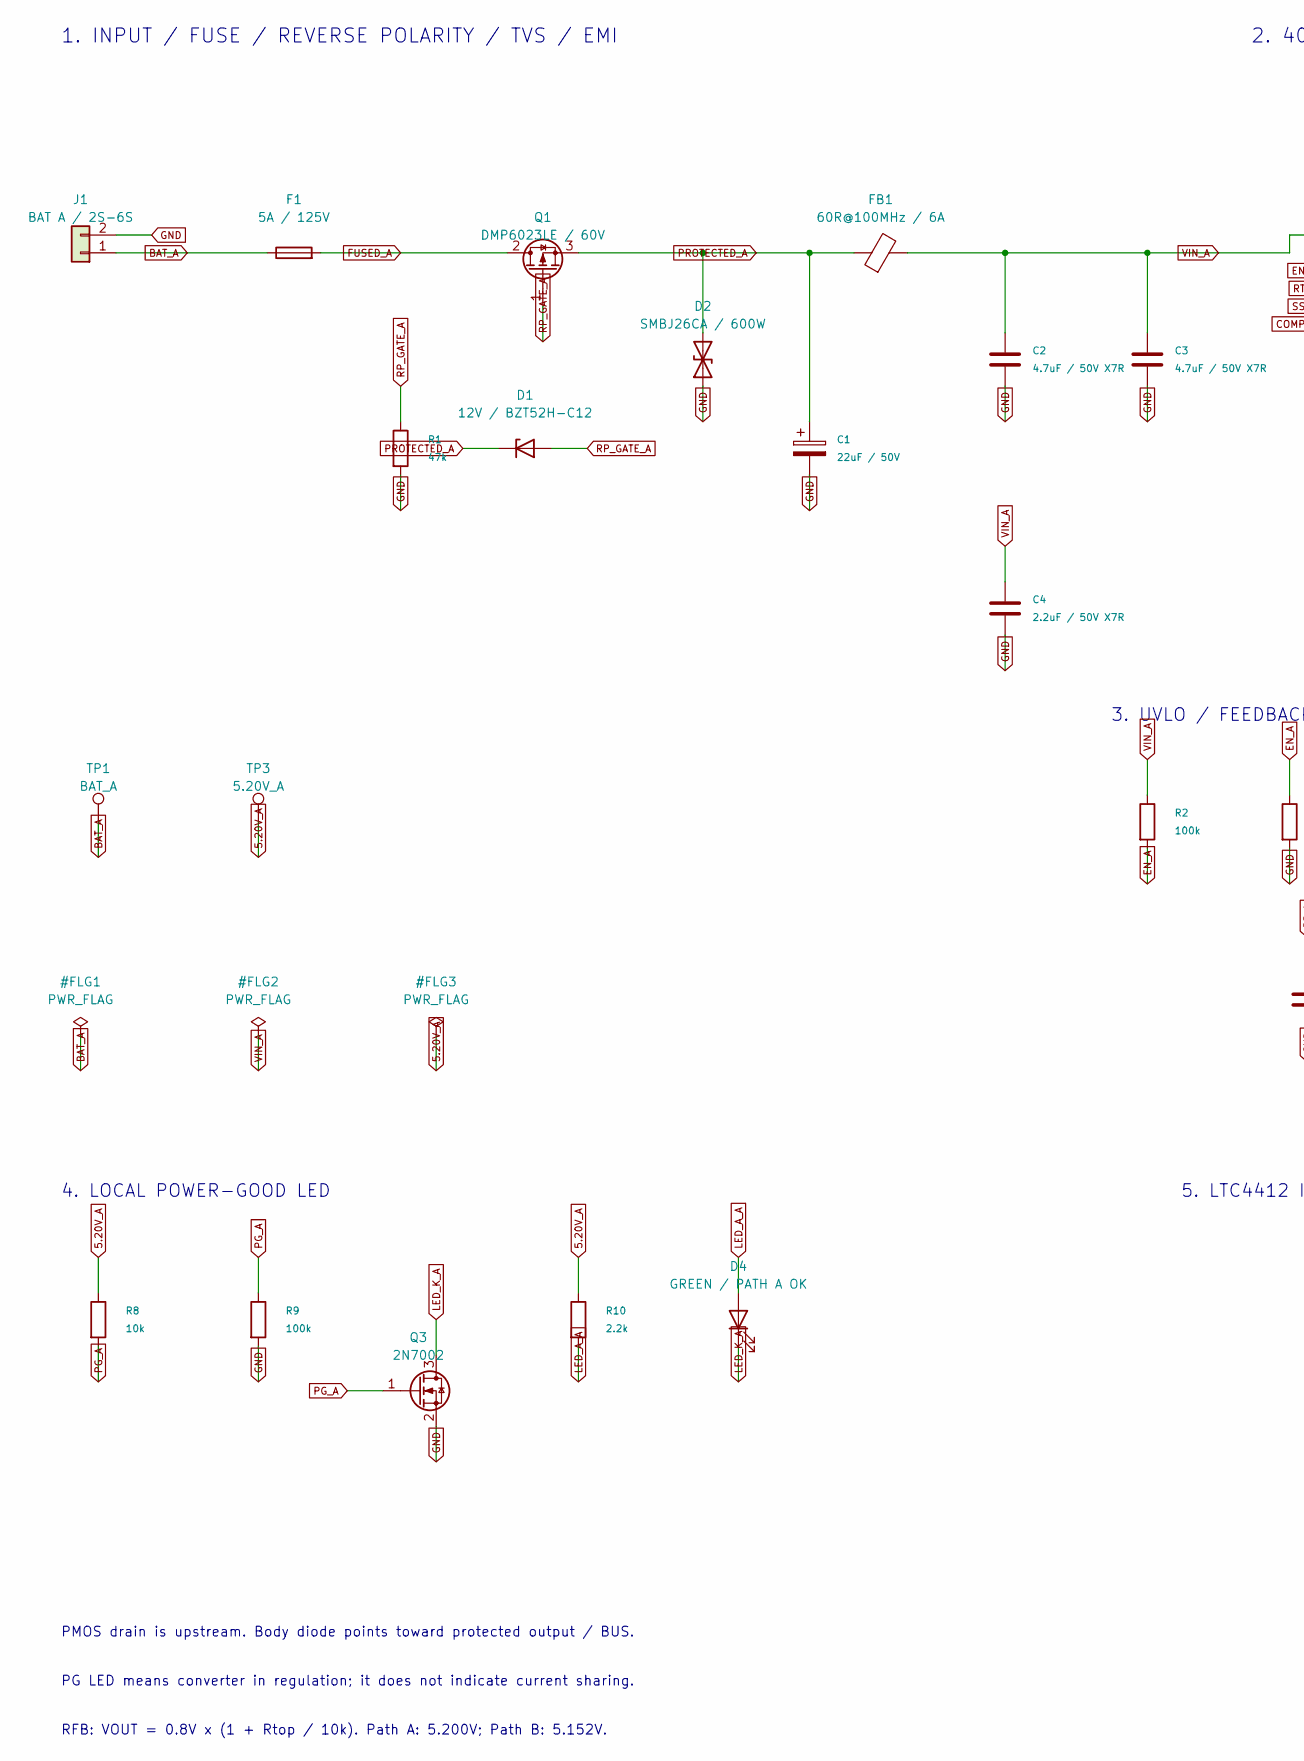
[picture p18: schematic Path_A.kicad_sch, RAPS-5 V1 - PATH A, part in row 1, column 1]

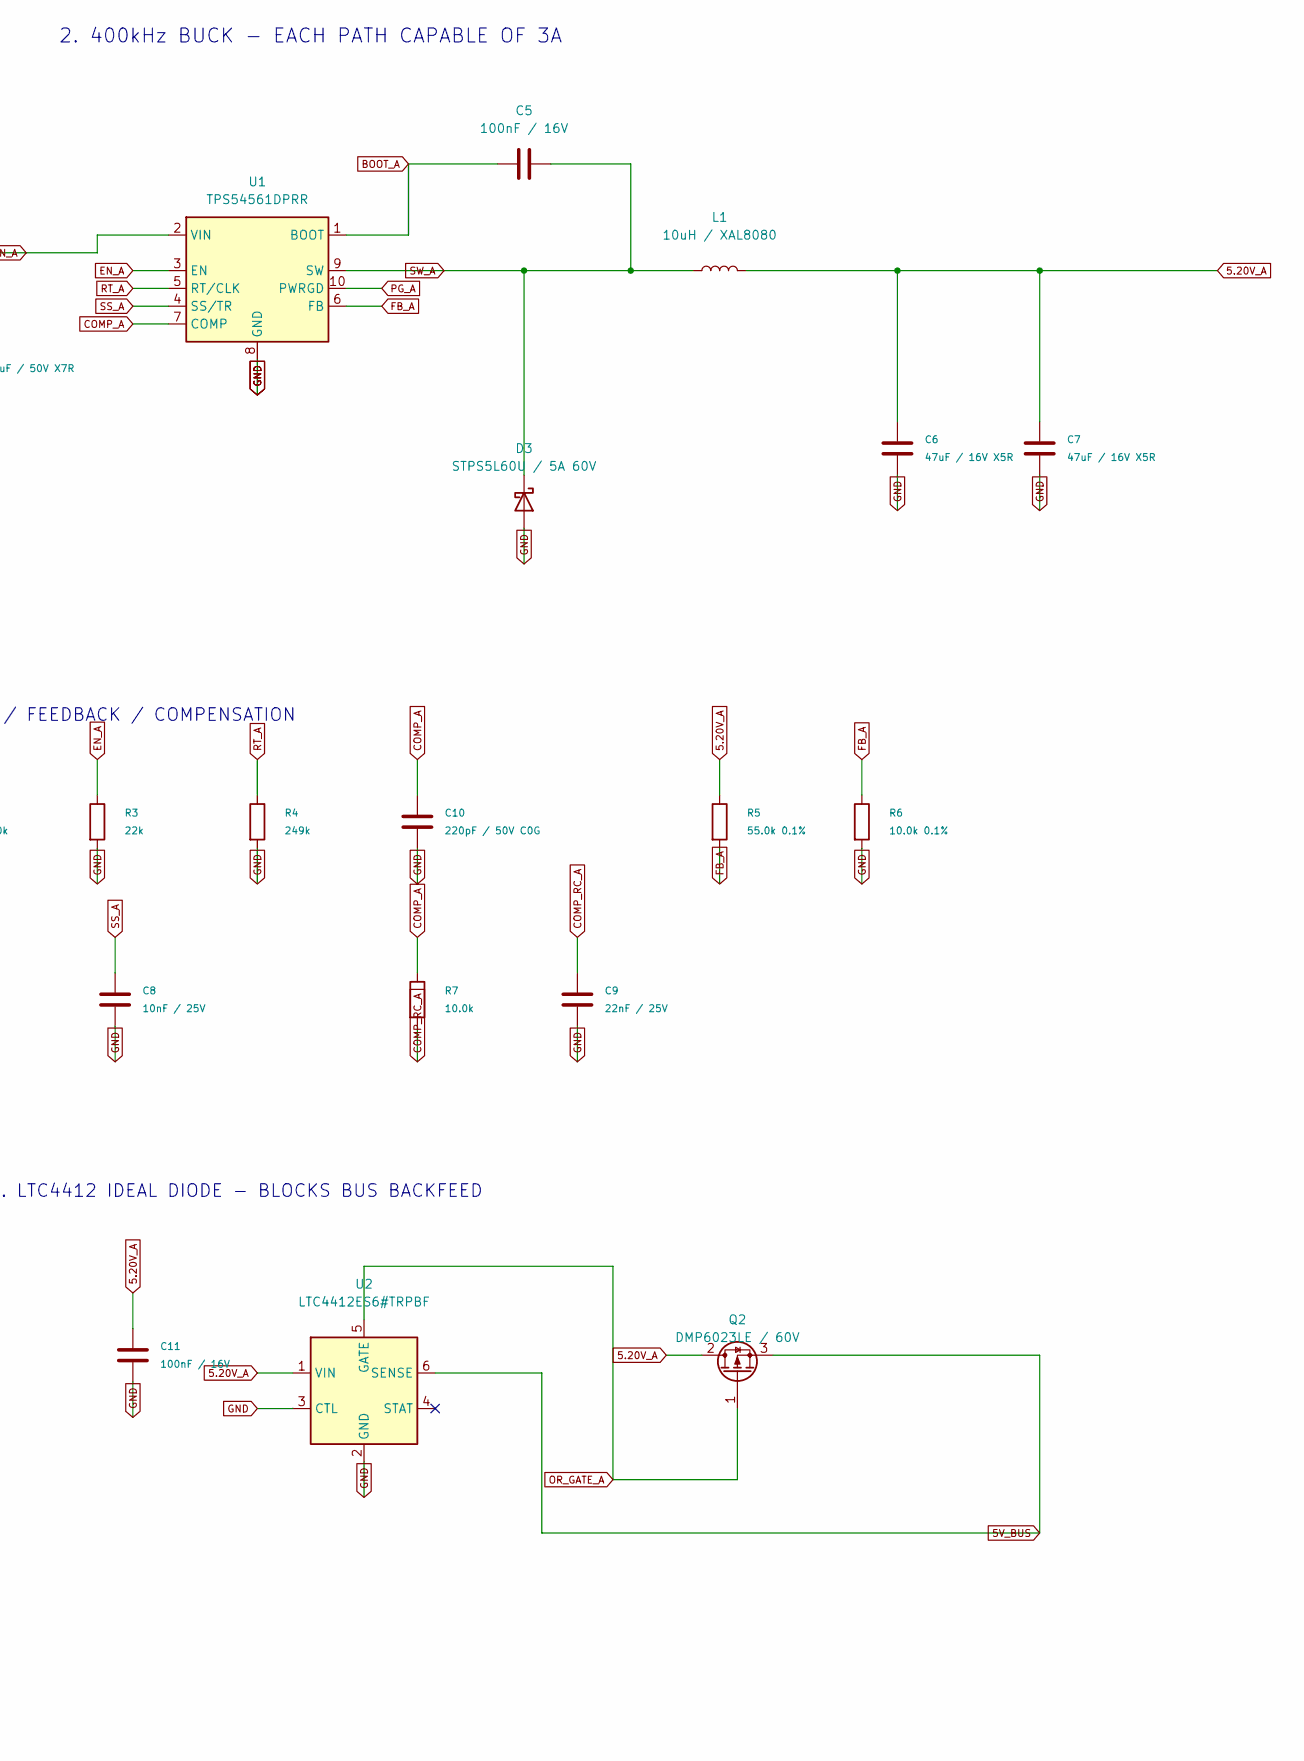
[picture p19: schematic Path_A.kicad_sch, RAPS-5 V1 - PATH A, part in row 1, column 2]

Parts:
C1: 22uF / 50V; CP_Elec_6.3x7.7; MPN EEE-FK1H220P
C2, C3: 4.7uF / 50V X7R; C_1210_3225Metric; MPN GRM32ER71H475KA88L
C4: 2.2uF / 50V X7R; C_0805_2012Metric; MPN GRM21BR71H225KA12L
C5, C11: 100nF / 16V; C_0603_1608Metric; MPN GRM188R71C104KA01D
C6, C7: 47uF / 16V X5R; C_1210_3225Metric; MPN GRM32ER61C476KE15L
C8: 10nF / 25V; C_0603_1608Metric; MPN GRM188R71E103KA01D
C9: 22nF / 25V; C_0603_1608Metric; MPN GRM188R71E223KA01D
C10: 220pF / 50V C0G; C_0603_1608Metric; MPN GRM1885C1H221JA01D
D1: 12V / BZT52H-C12; D_SOD-123F; MPN BZT52H-C12
D2: SMBJ26CA / 600W; D_SMB; MPN SMBJ26CA
D3: STPS5L60U / 5A 60V; D_SMB; MPN STPS5L60U
D4: GREEN / PATH A OK; LED_0603_1608Metric; MPN LTST-C190KGKT
F1: 5A / 125V; Fuse_Littelfuse-NANO2-451_453; MPN 0451005.MRL
FB1: 60R@100MHz / 6A; L_1806_4516Metric; MPN 742792410
J1: BAT A / 2S-6S; TerminalBlock_Phoenix_MKDS-1-2-3.81_1x02_P3.81mm_Horizontal; MPN 1727010
L1: 10uH / XAL8080; L_Coilcraft_XAL8080-XXX; MPN XAL8080-103MED
Q1, Q2: DMP6023LE / 60V; SOT-223-3_TabPin2; MPN DMP6023LE-13
Q3: 2N7002; SOT-23; MPN 2N7002-7-F
R1: 47k; R_0603_1608Metric; MPN RC0603FR-0747KL
R2, R9: 100k; R_0603_1608Metric
R3: 22k; R_0603_1608Metric
R4: 249k; R_0603_1608Metric
R5: 55.0k 0.1%; R_0603_1608Metric
R6: 10.0k 0.1%; R_0603_1608Metric
R7: 10.0k; R_0603_1608Metric
R8: 10k; R_0603_1608Metric
R10: 2.2k; R_0603_1608Metric
TP1: BAT_A; TestPoint_Pad_D1.0mm
TP3: 5.20V_A; TestPoint_Pad_D1.0mm
U1: TPS54561DPRR; WSON-10-1EP_4x4mm_P0.8mm_EP2.6x3mm; MPN TPS54561DPRR
U2: LTC4412ES6#TRPBF; TSOT-23-6; MPN LTC4412ES6#TRPBF

Connections:
5.20V_A: C6.1, C7.1, C11.1, L1.2, Q2.2 (D), R5.1, R8.1, R10.1, TP3.1, U2.1 (VIN)
5V_BUS: Q2.3 (S), U2.6 (SENSE); also elsewhere on the board
BAT_A: F1.1, J1.1, TP1.1
BOOT_A: C5.1, U1.1 (BOOT)
COMP_A: C10.1, R7.1, U1.7 (COMP)
COMP_RC_A: C9.1, R7.2
EN_A: R2.2, R3.1, U1.3 (EN)
FB_A: R5.2, R6.1, U1.6 (FB)
FUSED_A: F1.2, Q1.2 (D)
GND: C1.2, C2.2, C3.2, C4.2, C6.2, C7.2, C8.2, C9.2, C10.2, C11.2, D2.1 (A1), D3.2 (A), J1.2, Q3.2 (S), R1.2, R3.2, R4.2, R6.2, R9.2, U1.8 (GND), U1.11 (GND), U2.2 (GND), U2.3 (CTL); also elsewhere on the board
LED_A_A: D4.2 (A), R10.2
LED_K_A: D4.1 (K), Q3.3 (D)
OR_GATE_A: Q2.1 (G), U2.5 (GATE)
PG_A: Q3.1 (G), R8.2, R9.1, U1.10 (PWRGD); also elsewhere on the board
PROTECTED_A: C1.1, D1.1 (K), D2.2 (A2), FB1.1, Q1.3 (S)
RP_GATE_A: D1.2 (A), Q1.1 (G), R1.1
RT_A: R4.1, U1.5 (RT/CLK)
SS_A: C8.1, U1.4 (SS/TR)
SW_A: C5.2, D3.1 (K), L1.1, U1.9 (SW)
VIN_A: C2.1, C3.1, C4.1, FB1.2, R2.1, U1.2 (VIN)

Notes on the sheet:
1. INPUT / FUSE / REVERSE POLARITY / TVS / EMI
4. LOCAL POWER-GOOD LED
5. LTC4412 IDEAL DIODE - BLOCKS BUS BACKFEED
2. 400kHz BUCK - EACH PATH CAPABLE OF 3A
PG LED means converter in regulation; it does not indicate current sharing.
RFB: VOUT = 0.8V x (1 + Rtop / 10k). Path A: 5.200V; Path B: 5.152V.
PMOS drain is upstream. Body diode points toward protected output / BUS.
3. UVLO / FEEDBACK / COMPENSATION

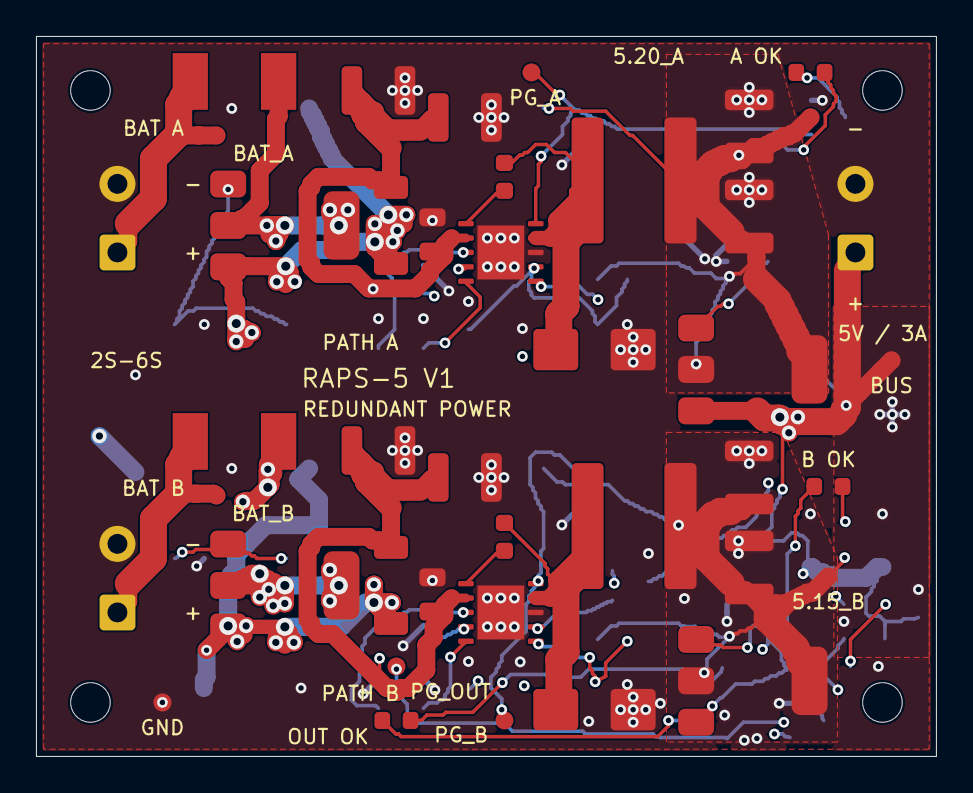
[picture p20: board RAPS-5_V1.kicad_pcb from above]

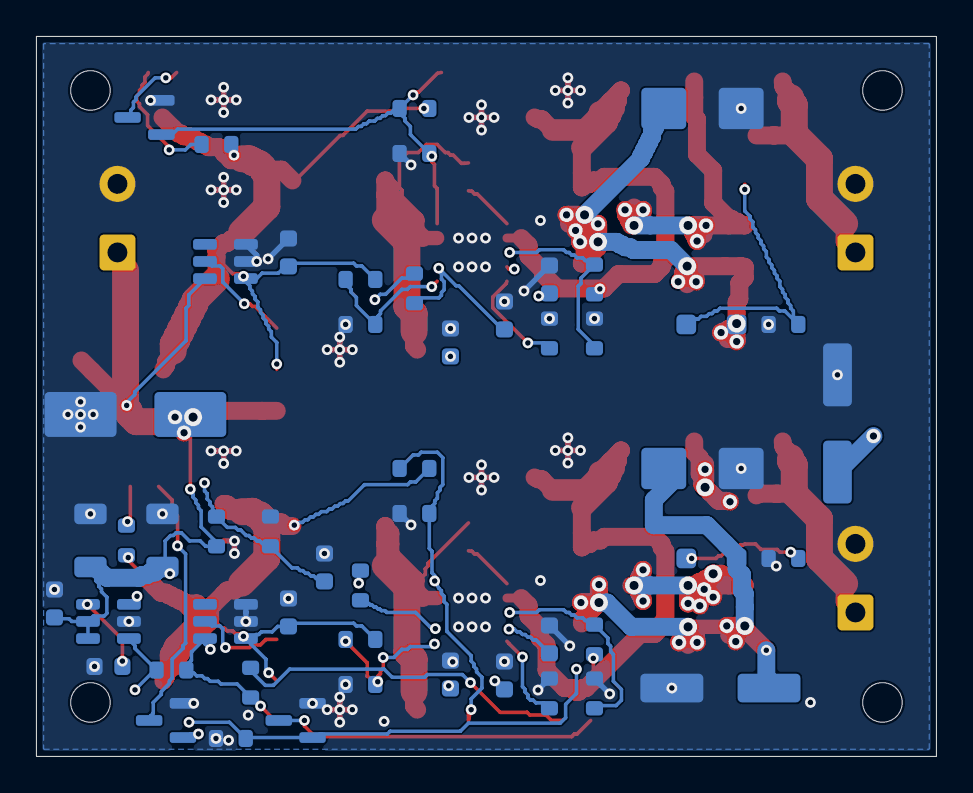
[picture p21: board RAPS-5_V1.kicad_pcb from below]

Board: 4 copper layers, 50.0 x 40.0 mm, 96 parts (51 on the bottom side), 43 nets.
