itsTasos/RAPS-5/(commit log)

2026-10-14 feat(hardware): add RAPS-5 V1 KiCad design
    [Path_A.kicad_sch, Path_B.kicad_sch, Path_O.kicad_sch, RAPS-5_V1.kicad_pcb, RAPS-5_V1.kicad_sch]
2026-10-14 build(manufacturing): add BOM and fabrication outputs
    [BOM.csv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]
2026-10-14 docs: add project overview and validation notes
    [bench_results.csv]
